khosta77/stm32g0-dev-board/RULES.md

# Правила расстановки и трассировки g0_dev_board

Свод практик, выработанных при трассировке платы и сверенных с документацией производителей.
Ссылаться на пункты как `RULES.md §N.M`. Стек, назначение листов и нумерация обозначений — в `CLAUDE.md`.
Источники — в конце файла, ссылки вида [S1].

## 1. Порядок работы

1.1. Плата разводится вручную, без автотрассировщика. Расстановка и дорожки задаются координатами
     (скрипты pcbnew или MCP KiCad) и проверяются рендером.

1.2. Работа идёт малыми блоками: блок → DRC → рендер → коммит → ревью → следующий блок.
     Порядок блоков: FT232 → ST-Link → Ethernet (W5500) → питание (LDO, +3.3V, JP101) → МК G0B1 →
     флэш/SD → шилд и гребёнки ЛА → шелкография.

1.3. Компоненты блока расставляются от точки входа (разъём, источник сигнала) и поворачиваются так,
     чтобы связи шли без пересечений и лишних переходов.

1.4. Между шагами плату могут править руками в KiCad. Перед любой автоматической правкой — `git diff`.
     Ручные правки не затираются: их переносят в скрипт блока или коммитят отдельно.

1.5. Перед правкой файлов скриптом KiCad закрыт (нет `*.lck`), изменения — на чистом git.

1.6. Требования производителя чипа (layout guide, app note) важнее общих правил этого файла.
     Перед разводкой блока его руководство читается, отступления фиксируются в коммите.

## 2. Геометрия дорожек

2.1. Сегменты только 0°, 90° и 45°. Повороты — фаской 45°, прямых и острых углов нет.
     Исключение: излом внутри площадки (например, связь площадок экрана разъёма через центры).
     Причина — технологичность (острые углы и узкие клинья у площадок дают «кислотные ловушки»
     при травлении) и аккуратность [S9]. На частотах платы прямой угол на сигнал не влияет [S7, S8],
     поэтому правило не повод удлинять критичную линию.

2.1a. Ответвления (Т-отводы) тоже не под 90°: ветвь отходит от линии отрезком 45° (Y-отвод).
     Это касается и отводов, сходящихся в центре площадки.

2.2. Диагонали 45° делаются длинными, где позволяет место: путь короче и ровнее
     (пример — SWDIO от R219 к JP801).

2.3. Сигнал идёт от элемента к элементу кратчайшим путём на одном слое.

2.4. Параллельные диагонали соседних выводов с шагом 0.5–0.65 мм не помещаются (зазор < 0.2 мм).
     Веер от ряда выводов делается «лесенкой»: дорожки выходят горизонтально и поворачивают
     по очереди, крайний вывод уходит дальше всех.

## 3. Ширина дорожек

3.1. Сигнальная дорожка от чипа к чипу — по ширине меньшей из площадок на концах (технологичность:
     дорожка не шире площадки). Для пар с контролем импеданса действует §3.5, для питания — §3.4.

3.2. После последовательного резистора ширина — по площадке чипа-приёмника
     (пример: от FT232 0.4 мм до R304/R305, дальше 0.3 мм к МК).

3.3. Минимальная ширина — 0.3 мм. Если 0.3 не проходит между площадками (ID разъёма USB),
     это фиксируется в сообщении коммита.

3.4. Питание: VBUS и +5V — 0.5 мм (по площадке разъёма USB). Отводы питания к выводам — по площадке
     вывода. Магистрали +3V3_STL на B.Cu — 0.3–0.4 мм. Ширина магистрали проверяется по току
     калькулятором завода (IPC-2152) [S15]; цифры не берутся по памяти.

3.5. Пары с контролем импеданса на стеке JLC 7628 (препрег 0.2104 мм, εr 4.4):
     - USB FS: 0.3 мм при шаге выводов 0.5 мм (~96 Ом); 0.35 мм / зазор 0.29 мм (~95 Ом).
       Цель по TI — 90 Ом ±15 % [S14].
     - Ethernet MDI 100 Ом: 0.3 мм / зазор 0.24 мм (~100 Ом по оценке). Укладывается в WIZnet:
       ширина 6–12 mil (0.15–0.3 мм), зазор в паре ≤ 10 mil (0.254 мм) [S1].
     Окончательные ширины — по калькулятору завода, импеданс зависит от маски и толщины меди [S2].

## 4. Переходные отверстия и слои

4.1. Переходные 0.4/0.3 мм (площадка/сверло). Кольцо 0.05 мм подтвердить у завода.

4.2. Стек: F.Cu сигналы / In1 GND / In2 GND / B.Cu. Оба внутренних слоя — сплошная GND без разрезов;
     аналоговая и цифровая части разносятся расстановкой, а не делением земли [S5, S1].

4.3. B.Cu — под силовые магистрали (+3V3_STL, VBUS, позже +3.3V) и под неизбежные переходы сигналов.
     B.Cu тоже держится планарным: перед магистралью проверить, какие области отрезаны жгутами.

4.4. Переход сигнала на B.Cu допустим только если его нельзя избежать по топологии
     (порядок выводов, захваченный вывод). Каждый такой переход указывается в коммите.
     В линиях MDI (TX±, RX± между W5500 и J401) переходных нет совсем [S1]. В цепях кварца — тоже [S2].

4.5. GND-выводы микросхем — переходными под корпусом (на внутренние GND). Это освобождает
     пространство вдоль ряда выводов для сигналов. Аналогично — выход захваченного сигнала под корпусом.

4.6. Если второй конец сигнала — THT-вывод, второе переходное не нужно: B.Cu садится прямо на вывод.

4.7. Сигнальное переходное F.Cu ↔ B.Cu меняет опорный слой In1 → In2. Рядом с ним, не дальше 1 мм
     от центра, ставится переходное GND — мост для обратного тока [S11, S12]. Для THT-вывода по §4.6
     мостом служит ближайшее GND-переходное или GND-вывод в пределах 1 мм; если его нет — ставится.
     Исключение: в плотных пучках, где в кольце 0.7-1.0 мм нет места без сдвига самих сигнальных
     переходов, мост допускается дальше (у g0_dev_board: 18 переходов, ближайший GND 1.1-5.6 мм —
     шина SPI2 у J806, ряд A0-A4, SWDIO, W_RST, колонка x 130 у W5500). Оценка: In1/In2 обе GND
     и сшиты по плате; лишняя индуктивность петли ~0.5 нГн (~0.5 Ом на 100 МГц) — несущественно.

4.8. Ряды переходных под корпусом и вдоль дорожек вырезают в плоскостях антипады. После заливки
     проверить, что под сигнальными линиями In1 не разорвана в щель.

## 5. Питание и развязка

5.1. Порядок: питание → конденсатор → нагрузка. Питание входит в площадку конденсатора,
     к выводу питания дорожка идёт от этой же площадки. Т-отводов к конденсатору нет [S4].

5.2. Переходное питания у конденсатора ставится со стороны, противоположной выводу нагрузки.

5.3. Несколько конденсаторов на одной шине — последовательно: источник → C1 → C2 → нагрузка
     (пример: D204 → C210 → C212 → +5V).

5.4. GND конденсатора — своё переходное вплотную к площадке, дорожка к нему короткая и не тоньше
     0.4 мм: индуктивность монтажа задают площадки и переходные, а не сам конденсатор [S3, S10].

5.5. Развязка каждого вывода VDD — по нетлисту, не по текстам на схеме (тексты бывают устаревшими).
     Один конденсатор на один вывод; конденсатор — на той же стороне, что и чип [S4, S6].

## 6. Длины и пары

6.1. Равная длина обязательна только для дифпар (USB, MDI): разница ≤ 0.5 мм, предел 1.27 мм [S13].
     Шины SWD, I2C, SPI на скоростях платы выравнивания не требуют: перекос в сантиметры даёт
     десятки пикосекунд при периоде в десятки наносекунд [S16, S17]. Змейки на них не делаются,
     линии ведутся кратчайшим путём.

6.2. Длина пары считается для всей линии от вывода до вывода, включая участки по обе стороны
     последовательных элементов. Отводы (терминаторы, подтяжки) в длину пути не входят.
     KiCad показывает длину каждой цепи отдельно и учитывает отводы — сверять по скрипту.

6.3. Выравнивание пары — змейкой с фасками 45° на одной линии, на участке, где линии пары уже
     разошлись, ближе к месту, где возникла разница.

6.4. Кварц — вплотную к чипу, дорожки OSC короткие [S2]. Корпус симметричен относительно выводов OSC,
     нагрузочные конденсаторы — симметрично, их GND — переходными рядом, на ближайшую к чипу землю.

6.5. Дифпары идут параллельно с постоянным зазором. Если порядок линий у разъёма и у чипа зеркальный
     (это не зависит от поворота чипа), пара один раз перекрещивается:
     - MDI — без переходных: одна линия проходит между площадками последовательного конденсатора
       другой линии (§7.2) или огибает THT-вывод разъёма;
     - USB — так же, если есть последовательный элемент; иначе одна линия уходит на B.Cu
       на минимальной длине с GND-переходным по §4.7.

6.6. Цепи кварца (AN2867 [S2], WIZnet [S1]):
     - под кварцем, между его выводами и нагрузочными конденсаторами чужих дорожек нет;
     - ВЧ-линии (SPI, тактовые, MDI) — в стороне; рядом с OSC они допустимы только на выходе
       из соседних выводов корпуса;
     - один кварц — одному чипу.
     Исключение: дорожки на B.Cu под корпусом THT-кварца (Y401) допускаются, если на In1/In2
     под ним сплошная GND, а до площадок кварца не меньше 0.5 мм. Нужно, когда другого пути
     для линий нет (так у Y401: только там помещаются линии от МК к J803/J804/J805).
     Исключение 2: линии SPI W5500 (выводы 32-36) по B.Cu пересекают отрезки X0/X1 между
     площадками кварца и выводами 30/31 W5500 — перпендикулярно, вне корпуса кварца, при
     сплошной GND на In1/In2. Другого пути от МК к выводам 32-36 нет: они лежат по другую
     сторону выводов 30/31, а под кварцем пять линий не помещаются.

## 7. Расстановка

7.1. ESD-защита — первой у разъёма, перед остальными компонентами линии.

7.2. Резистор или конденсатор 0805 работает как мостик: между его площадками (0.8 мм у R, 0.9 мм у C)
     проходит дорожка 0.3 мм. Так линию пропускают через «петлю» без перехода (SWCLK под R222/R219).

7.3. Курт-ярды не пересекаются. Дорожки внутри чужого курт-ярда допустимы.

7.4. Полоса подписей вдоль гребёнок ЛА J805/J806 — без разъёмов и деталей.

7.5. Перемычки JP801/JP201/JP101 можно ставить под зону шилда: после отладки они снимаются.

7.6. Под шилдом (зона Uno) — только детали высотой ≤ ~8 мм.

7.7. Светодиоды индикации — вне зоны шилда, на видном месте.

7.8. Последовательный (демпфирующий) резистор ставится у передатчика линии: отрезок до него
     работает как индуктивность и ослабляет демпфирование [S18, S19]. Если передатчик на другом
     блоке (SCK/MOSI/CS/RST от МК к W5500) — резистор ставится при разводке того блока.

7.9. Ethernet (WIZnet [S1]):
     - W5500 — как можно ближе к J401, длина MDI ≤ 25 мм (предел 75 мм);
     - зазор между парами TX и RX ≥ 0.5 мм, от остальных цепей ≥ 0.5 мм, по возможности с GND между ними;
     - между W5500 и J401 не проходят цифровые линии; кварц и другие ВЧ-источники — в стороне от MDI;
     - терминаторы RX — у приёмника (W5500).

7.10. Под передней (кабельной) частью J401 во внутренних слоях GND вырез [S1]: от полосы ниже
      ряда выводов 1–8 до края платы. MDI до самых выводов идёт над сплошной GND.
      В HR911105A магнитика встроена, и прямо о таком корпусе WIZnet не говорит — это осторожное
      толкование, его можно пересмотреть.

## 8. Проверка блока перед коммитом

8.1. `kicad-cli pcb drc --schematic-parity`: 0 нарушений внутри блока, 0 расхождений со схемой.
     Неподключёнными допускаются только межблочные цепи; они перечисляются в коммите.

8.2. Скрипт углов: 0 сегментов с наклоном не 0/45/90° (допуск 0.01°), 0 поворотов острее 135°,
     0 Т-отводов под 90° (проверяются и середины сегментов, и центры площадок).

8.3. Длины пар — скриптом по §6.2.

8.4. Скрипт переходных: у каждого сигнального переходного есть GND-переходное в пределах 1 мм (§4.7);
     в цепях MDI и OSC переходных нет (§4.4).

8.5. Рендер блока (F.Cu + B.Cu) и визуальная проверка.

8.6. Изменения схемы — ERC 0, текстовые блоки и поля (Description, LCSC) обновлены вместе с символом.

8.7. Факты о номерах деталей (LCSC и т.п.) не придумываются: если номер неизвестен, поле остаётся
     пустым и это отмечается.

## 9. Коммиты

9.1. Conventional Commits: заголовок на английском, тело на русском.
9.2. В теле: что сделано, какие переходы на B.Cu и почему, отклонения от правил, что осталось неподключённым.

## Источники

- [S1] WIZnet, Hardware Design Guide и Ethernet Design Guide: https://docs.wiznet.io/Design-Guide/hardware_design_guide
- [S2] ST AN2867, Oscillator design guide, раздел 7.1:
  https://www.st.com/resource/en/application_note/an2867-oscillator-design-guide-for-stm32-microcontrollers-stmicroelectronics.pdf
- [S3] TI SPRAC76G, индуктивность монтажа конденсаторов:
  https://www.ti.com/document-viewer/ja-jp/lit/html/SPRAC76G/GUID-A8B7C278-98DB-4D34-A92C-5DA11A9E4475
- [S4] Microchip, Decoupling Capacitors:
  https://onlinedocs.microchip.com/oxy/GUID-D6315DA4-4399-4D39-80F4-F1F66A173640-en-US-3/GUID-ADE90D4D-2E78-42F4-A206-D6E72CECC5CA.html
- [S5] H. Ott, разбиение вместо разреза плоскости (пересказ Autodesk):
  https://www.autodesk.com/products/fusion-360/blog/everyday-app-note-successfully-design-mixed-signal-pcb-partitioning/
- [S6] ST AN5096 (STM32G0 hardware): 100 нФ на каждый VDD, 4.7 мкФ общий — по пересказу, сверить с PDF:
  https://www.eevblog.com/forum/beginners/stm32g0-series-power-supply
- [S7] E. Bogatin, прямые углы: https://www.signalintegrityjournal.com/articles/2104-should-worry-about-90-degree-bends-in-circuit-board-traces
- [S8] Altium, мифы про углы: https://resources.altium.com/p/pcb-routing-angle-myths-45-degree-angle-versus-90-degree-angle
- [S9] NextPCB, acid traps: https://www.nextpcb.com/blog/acid-traps
- [S10] Altium, подключение конденсаторов: https://resources.altium.com/p/decoupling-capacitor-connections-traces-or-vias
- [S11] RF Essentials, переход между слоями:
  https://rfessentials.com/rf-knowledge-base/what-is-the-proper-technique-for-transitioning-a-signal-between-layers-on-a-mult/
- [S12] ICD, No one-way trips: https://www.icd.com.au/articles/No_oneway_trips_PCBD-Apr2014.pdf
- [S13] TI TUSB2036, layout: https://www.ti.com/document-viewer/TUSB2036/datasheet/layout
- [S14] TI SLLA414: https://ti.com/lit/slla414
- [S15] PCBSync, IPC-2152: https://pcbsync.com/?p=32084
- [S16] критическая длина: https://engineering-notes-010.pages.dev/09-Electrical-Foundations/Signal-Integrity
- [S17] выравнивание тактов и данных: https://applied-ee.github.io/ee-notebook/docs/measurement/digital-logic-protocols/clock-data-alignment
- [S18] Sigcon, How Close is Close Enough: https://sigcon.com/Pubs/edn/close.htm
- [S19] Zuken, размещение согласующих резисторов:
  https://www.zuken.com/us/blog/tech-tip-termination-resistor-placement-with-pin-pair-constraints-in-cr-8000/
