khosta77/stm32g0-dev-board/manufacturing/BOM-g0_dev_board.csv

Comment | Designator | Footprint | LCSC Part #
100n | C101,C102,C103,C105,C107,C201,C202,C204,C205,C209,C212,C303,C304,C305,C403,C404,C405,C408,C410,C412,C413,C503,C505,C702 | C_0805_2012Metric | C49678
4.7u | C104,C203,C206,C306,C416 | C_0805_2012Metric | C1779
6.8p C0G | C106,C108 | C_0805_2012Metric | C1832
10u | C207,C210,C409,C414,C502,C504 | C_0805_2012Metric | C15850
22p | C208,C211 | C_0805_2012Metric | C1804
10n | C302,C415,C417 | C_0805_2012Metric | C1710
33p C0G | C401,C402 | C_0805_2012Metric | C157687
6n8 | C406,C407 | C_0805_2012Metric | C1755
22n | C411 | C_0805_2012Metric | C1729
100n X7R | C501,C601,C602 | C_0805_2012Metric | C49678
LED_Red | D201 | LED_0805_2012Metric | C84256
LED_Green | D202 | LED_0805_2012Metric | C2297
LED | D203,D401,D402,D403,D404 | LED_0805_2012Metric | C2297
B120 | D204,D301,D801 | D_SMA | C134421
TX | D302 | LED_0805_2012Metric | C2297
RX | D303 | LED_0805_2012Metric | C2297
BAT54WS | D802 | D_SOD-323_HandSoldering | C124205
MF-MSMF075-2 | F201 | Fuse_1812_4532Metric | C84140
600R@100MHz 0.5A | FB101,FB401 | L_0805_2012Metric | C1017
220R@100MHz 2A | FB301 | L_0805_2012Metric | C85840
USB_B_Mini | J201,J301 | USB_Mini-B_Lumberg_2486_01_Horizontal
F103_SWD | J202 | PinHeader_1x05_P2.54mm_Vertical | C42431835
RJ45_Hanrun_HR911105A_Horizontal | J401 | RJ45_Hanrun_HR911105A_Horizontal | C12074
DM3AT-SF-PEJM5 | J501 | microSD_HC_Hirose_DM3AT-SF-PEJM5 | C114218
Uno_IOH | J801 | PinSocket_1x10_P2.54mm_Vertical | C2905418
Uno_IOL | J802 | PinSocket_1x08_P2.54mm_Vertical | C42431840
Uno_POWER | J803 | PinSocket_1x08_P2.54mm_Vertical | C42431840
Uno_ANALOG | J804 | PinSocket_1x06_P2.54mm_Vertical | C40877
J_LA_L | J805 | PinHeader_1x27_P2.54mm_Vertical
J_LA_R | J806 | PinHeader_1x27_P2.54mm_Vertical
JP_IDD | JP101 | PinHeader_1x02_P2.54mm_Vertical | C42431798
JP_STL_PWR | JP201 | PinHeader_1x02_P2.54mm_Vertical | C42431798
JP_SWD | JP801 | PinHeader_2x03_P2.54mm_Vertical
GREEN | LD701 | LED_0805_2012Metric | C2297
RED | LD702 | LED_0805_2012Metric | C84256
MMBT3904 | Q201 | SOT-23 | C20526
1k | R101,R302,R304,R305 | R_0805_2012Metric | C17513
330 | R201,R202,R203,R306,R307,R424,R425,R426,R427,R429,R430,R701 | R_0805_2012Metric | C17630
4k7 | R204,R210 | R_0805_2012Metric | C17673
100k | R205,R206,R208,R209,R215,R704 | R_0805_2012Metric | C149504
10k | R207,R216,R401,R402,R403,R410,R411,R412,R413,R414,R415,R416,R417,R505,R511,R516,R517 | R_0805_2012Metric | C17414
0 | R211,R213,R214,R223,R301 | R_0805_2012Metric | C17477
1k5 | R212 | R_0805_2012Metric | C4310
36k | R217 | R_0805_2012Metric | C4360
100 | R218,R222 | R_0805_2012Metric | C17408
22 | R219,R220,R221,R404,R405,R406,R407,R408,R409 | R_0805_2012Metric | C17561
2.2k | R303 | R_0805_2012Metric | C17520
1M | R418 | R_0805_2012Metric | C17514
49R9 1% | R419,R420,R422,R423 | R_0805_2012Metric | C17720
10R 1% | R421 | R_0805_2012Metric | C17415
12k4 1% | R428 | R_0805_2012Metric | C30908
10 | R501,R502,R503,R504,R507,R508,R509,R510 | R_0805_2012Metric | C17415
47k | R506,R512,R513,R514,R515 | R_0805_2012Metric | C17713
4.7k | R601,R602 | R_0805_2012Metric | C17673
680 | R702 | R_0805_2012Metric | C17798
10k | RV101 | Potentiometer_Bourns_3314J_Vertical | C36376
RESET | SW701 | SW_SPST_PTS645Sx43SMTR92 | C221880
USER | SW702 | SW_SPST_PTS645Sx43SMTR92 | C221880
STM32G0B1CCT6 | U101 | LQFP-48_7x7mm_P0.5mm | C5270241
USBLC6-2SC6 | U201,U301 | SOT-23-6 | C7519
AP7361C-33E | U202 | SOT-223-3_TabPin2 | C500795
STM32F103CBTx | U203 | LQFP-48_7x7mm_P0.5mm | C8304
FT232RL | U302 | SSOP-28_5.3x10.2mm_P0.65mm | C8690
W5500 | U401 | LQFP-48_7x7mm_P0.5mm | C32843
W25Q32JVSSIQ | U501 | SOIC-8_5.3x5.3mm_P1.27mm | C179173
TMP100 | U601,U602 | SOT-23-6 | C31810
32.768kHz CL7pF | Y101 | Crystal_SMD_G8-2Pin_3.2x1.5mm_HandSoldering | C48615
8MHz | Y201 | Crystal_HC49-4H_Vertical | C21263
25MHz | Y401 | Crystal_HC49-4H_Vertical | C14730
