khosta77/stm32g0-dev-board/g0_dev_board.kicad_pcb

## KiCad design g0_dev_board.kicad_pcb (2026-11-07)

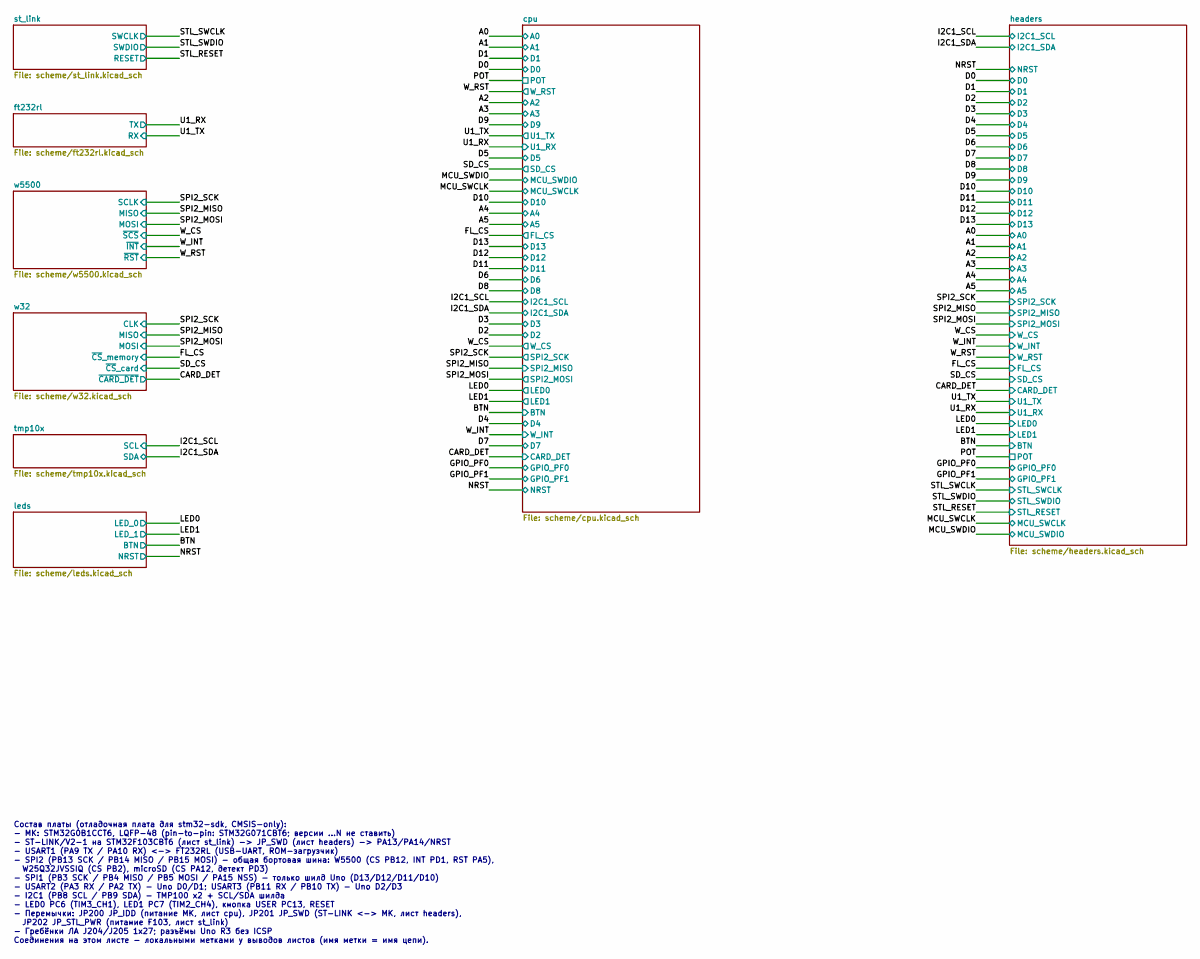
[picture p11: schematic g0_dev_board.kicad_sch, G0 dev board]

Notes on the sheet:
Состав платы (отладочная плата для stm32-sdk, CMSIS-only): - МК: STM32G0B1CCT6, LQFP-48 (pin-to-pin: STM32G071CBT6; версии ...N не ставить) - ST-LINK/V2-1 на STM32F103CBT6 (лист st_link) -> JP_SWD (лист headers) -> PA13/PA14/NRST - USART1 (PA9 TX / PA10 RX) <-> FT232RL (USB-UART, ROM-загрузчик) - S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

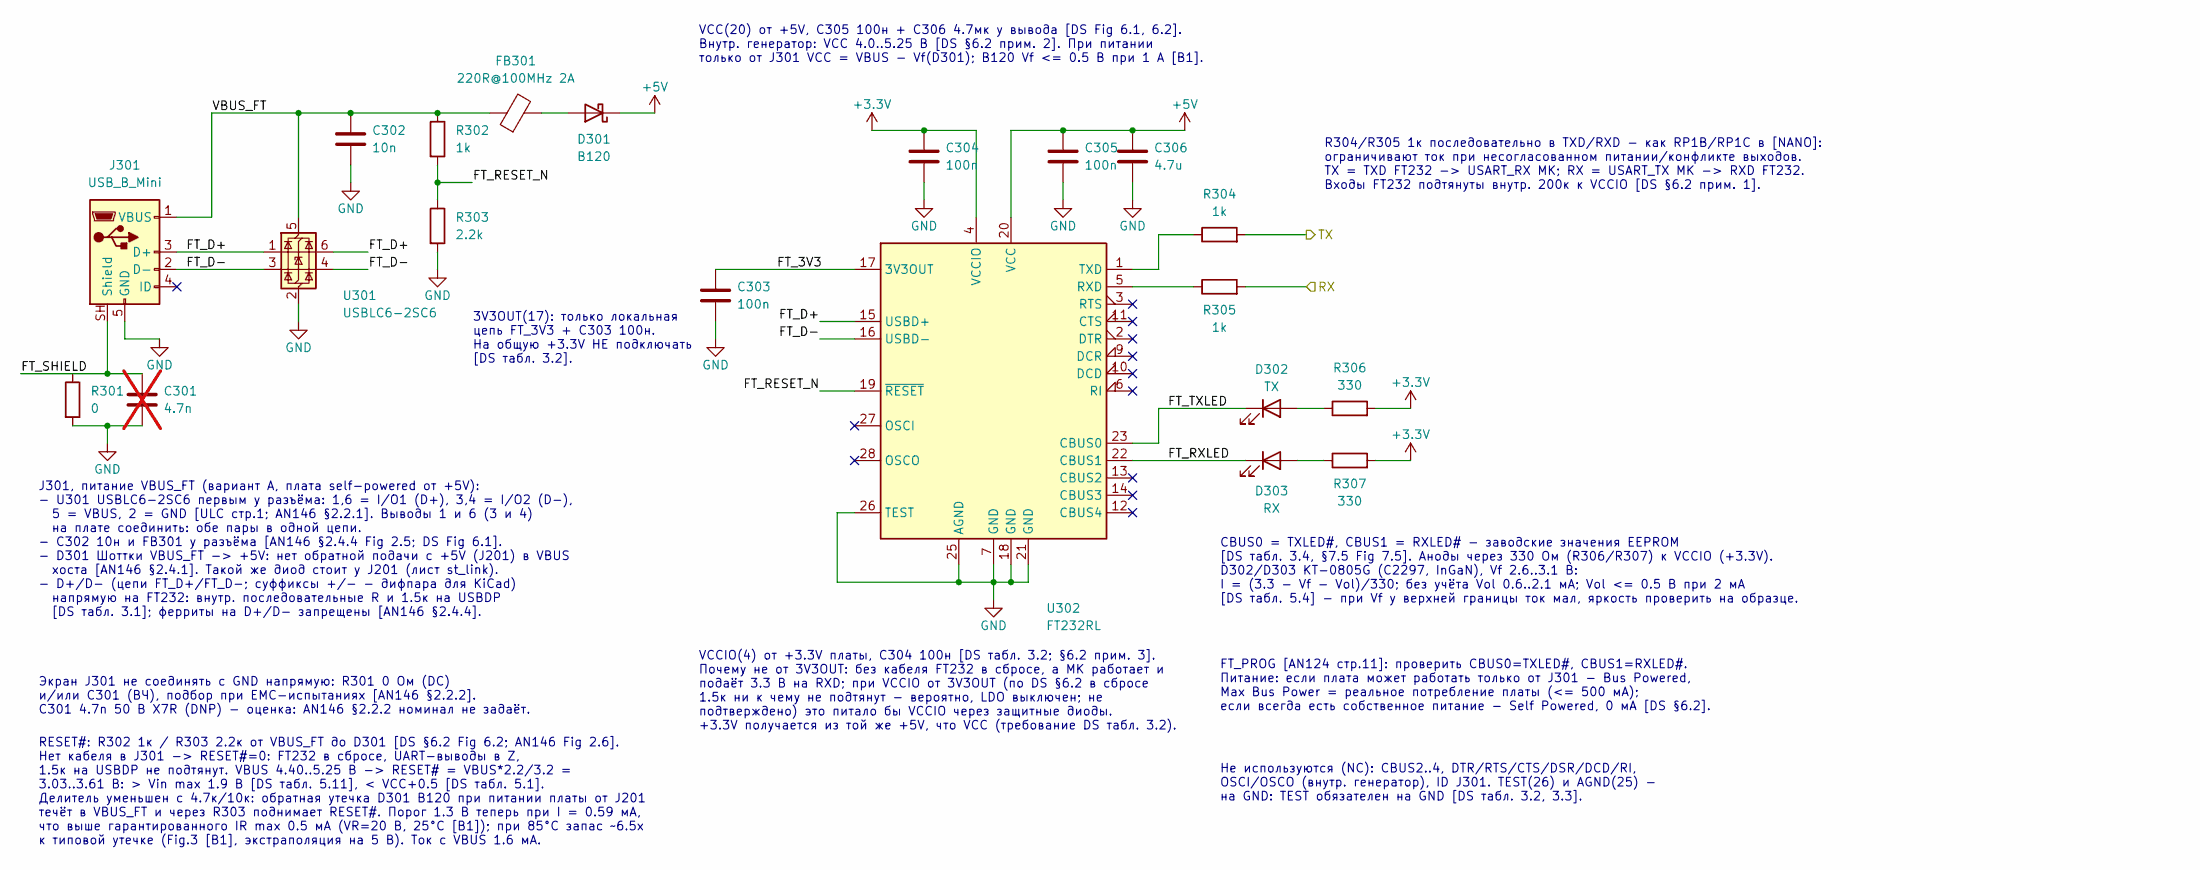
[picture p12: schematic ft232rl.kicad_sch]

Parts:
C301: 4.7n; C_0805_2012Metric; LCSC C1744; not fitted
C302: 10n; C_0805_2012Metric; LCSC C1710
C303, C304, C305: 100n; C_0805_2012Metric; LCSC C49678
C306: 4.7u; C_0805_2012Metric; LCSC C1779
D301: B120; D_SMA; MPN B120-13-F; LCSC C134421
D302: TX; LED_0805_2012Metric; LCSC C2297
D303: RX; LED_0805_2012Metric; LCSC C2297
FB301: 220R@100MHz 2A; L_0805_2012Metric; MPN BLM21PG221SN1D; LCSC C85840
J301: USB_B_Mini; USB_Mini-B_Lumberg_2486_01_Horizontal
R301: 0; R_0805_2012Metric; LCSC C17477
R302, R304, R305: 1k; R_0805_2012Metric; LCSC C17513
R303: 2.2k; R_0805_2012Metric; LCSC C17520
R306, R307: 330; R_0805_2012Metric; LCSC C17630
U301: USBLC6-2SC6; SOT-23-6; MPN USBLC6-2SC6; LCSC C7519
U302: FT232RL; SSOP-28_5.3x10.2mm_P0.65mm; LCSC C8690

Connections:
+3.3V: C304.1, R306.2, R307.2, U302.4 (VCCIO); also elsewhere on the board
+5V: C305.1, C306.1, D301.1 (K), U302.20 (VCC); also elsewhere on the board
/U1_RX: R304.2; also elsewhere on the board
/U1_TX: R305.2; also elsewhere on the board
/ft232rl/FT_3V3: C303.1, U302.17 (3V3OUT)
/ft232rl/FT_D+: J301.3 (D+), U301.1 (I/O1), U301.6 (I/O1), U302.15 (USBD+)
/ft232rl/FT_D-: J301.2 (D-), U301.3 (I/O2), U301.4 (I/O2), U302.16 (USBD-)
/ft232rl/FT_RESET_N: R302.2, R303.1, U302.19 (~RESET)
/ft232rl/FT_RXLED: D303.1 (K), U302.22 (CBUS1)
/ft232rl/FT_SHIELD: C301.1, J301.SH (Shield), R301.1
/ft232rl/FT_TXLED: D302.1 (K), U302.23 (CBUS0)
/ft232rl/VBUS_FT: C302.1, FB301.1, J301.1 (VBUS), R302.1, U301.5 (VBUS)
GND: C301.2, C302.2, C303.2, C304.2, C305.2, C306.2, J301.5 (GND), R301.2, R303.2, U301.2 (GND), U302.7 (GND), U302.18 (GND), U302.21 (GND), U302.25 (AGND), U302.26 (TEST); also elsewhere on the board
unnamed: D301.2 (A), FB301.2
unnamed: D302.2 (A), R306.1
unnamed: D303.2 (A), R307.1
unnamed: R305.1, U302.5 (RXD)
unnamed: R304.1, U302.1 (TXD)

Notes on the sheet:
RESET#: R302 1к / R303 2.2к от VBUS_FT до D301 [DS §6.2 Fig 6.2; AN146 Fig 2.6]. Нет кабеля в J301 -> RESET#=0: FT232 в сбросе, UART-выводы в Z, 1.5к на USBDP не подтянут. VBUS 4.40..5.25 В -> RESET# = VBUS*2.2/3.2 = 3.03..3.61 В: > Vin max 1.9 В [DS табл. 5.11], < VCC+0.5 [DS табл. 5.1]. Делитель 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
R304/R305 1к последовательно в TXD/RXD - как RP1B/RP1C в [NANO]: ограничивают ток при несогласованном питании/конфликте выходов. TX = TXD FT232 -> USART_RX МК; RX = USART_TX МК -> RXD FT232. Входы FT232 подтянуты внутр. 200к к VCCIO [DS §6.2 прим. 1].
3V3OUT(17): только локальная цепь FT_3V3 + C303 100н. На общую +3.3V НЕ подключать [DS табл. 3.2].
VCCIO(4) от +3.3V платы, C304 100н [DS табл. 3.2; §6.2 прим. 3]. Почему не от 3V3OUT: без кабеля FT232 в сбросе, а МК работает и подаёт 3.3 В на RXD; при VCCIO от 3V3OUT (по DS §6.2 в сбросе 1.5к ни к чему не подтянут - вероятно, LDO выключен; не подтверждено) это питало бы VCCIO через защитные дио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
VCC(20) от +5V, C305 100н + C306 4.7мк у вывода [DS Fig 6.1, 6.2]. Внутр. генератор: VCC 4.0..5.25 В [DS §6.2 прим. 2]. При питании только от J301 VCC = VBUS - Vf(D301); B120 Vf <= 0.5 В при 1 А [B1].
FT_PROG [AN124 стр.11]: проверить CBUS0=TXLED#, CBUS1=RXLED#. Питание: если плата может работать только от J301 - Bus Powered, Max Bus Power = реальное потребление платы (<= 500 мА); если всегда есть собственное питание - Self Powered, 0 мА [DS §6.2].
Не используются (NC): CBUS2..4, DTR/RTS/CTS/DSR/DCD/RI, OSCI/OSCO (внутр. генератор), ID J301. TEST(26) и AGND(25) - на GND: TEST обязателен на GND [DS табл. 3.2, 3.3].
J301, питание VBUS_FT (вариант A, плата self-powered от +5V): - U301 USBLC6-2SC6 первым у разъёма: 1,6 = I/O1 (D+), 3,4 = I/O2 (D-), 5 = VBUS, 2 = GND [ULC стр.1; AN146 §2.2.1]. Выводы 1 и 6 (3 и 4) на плате соединить: обе пары в одной цепи. - C302 10н и FB301 у разъёма [AN146 §2.4.4 Fig 2.5; DS Fi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
CBUS0 = TXLED#, CBUS1 = RXLED# - заводские значения EEPROM [DS табл. 3.4, §7.5 Fig 7.5]. Аноды через 330 Ом (R306/R307) к VCCIO (+3.3V). D302/D303 KT-0805G (C2297, InGaN), Vf 2.6..3.1 В: I = (3.3 - Vf - Vol)/330; без учёта Vol 0.6..2.1 мА; Vol <= 0.5 В при 2 мА [DS табл. 5.4] - при Vf у верхней гра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
Экран J301 не соединять с GND напрямую: R301 0 Ом (DC) и/или C301 (ВЧ), подбор при EMC-испытаниях [AN146 §2.2.2]. C301 4.7n 50 В X7R (DNP) - оценка: AN146 §2.2.2 номинал не задаёт.

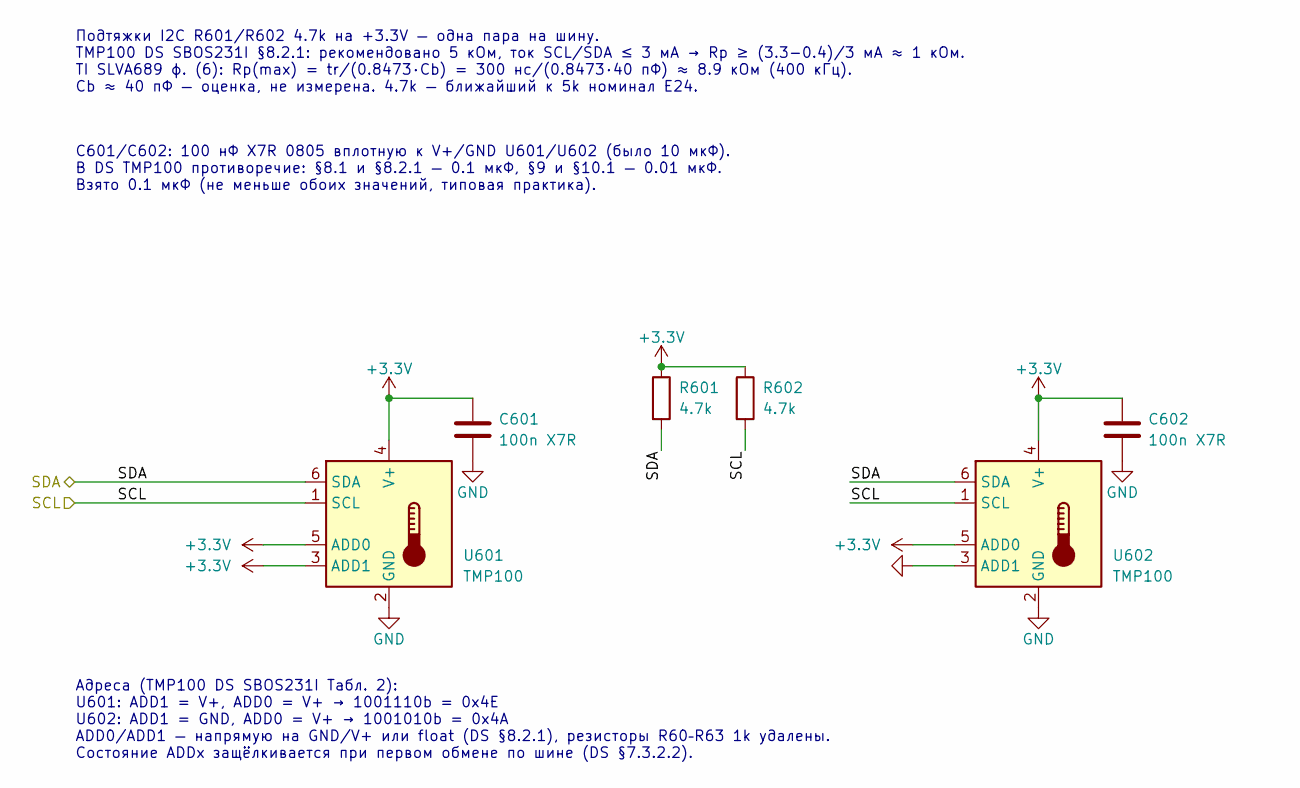
[picture p13: schematic tmp10x.kicad_sch]

Parts:
C601, C602: 100n X7R; C_0805_2012Metric; LCSC C49678
R601, R602: 4.7k; R_0805_2012Metric; LCSC C17673
U601, U602: TMP100; SOT-23-6; LCSC C31810

Connections:
+3.3V: C601.1, C602.1, R601.1, R602.1, U601.3 (ADD1), U601.4 (V+), U601.5 (ADD0), U602.4 (V+), U602.5 (ADD0); also elsewhere on the board
/I2C1_SCL: R602.2, U601.1 (SCL), U602.1 (SCL); also elsewhere on the board
/I2C1_SDA: R601.2, U601.6 (SDA), U602.6 (SDA); also elsewhere on the board
GND: C601.2, C602.2, U601.2 (GND), U602.2 (GND), U602.3 (ADD1); also elsewhere on the board

Notes on the sheet:
Подтяжки I2C R601/R602 4.7k на +3.3V — одна пара на шину. TMP100 DS SBOS231I §8.2.1: рекомендовано 5 кОм, ток SCL/SDA ≤ 3 мА → Rp ≥ (3.3−0.4)/3 мА ≈ 1 кОм. TI SLVA689 ф. (6): Rp(max) = tr/(0.8473·Cb) = 300 нс/(0.8473·40 пФ) ≈ 8.9 кОм (400 кГц). Cb ≈ 40 пФ — оценка, не измерена. 4.7k — ближайший к 5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
Адреса (TMP100 DS SBOS231I Табл. 2): U601: ADD1 = V+, ADD0 = V+ → 1001110b = 0x4E U602: ADD1 = GND, ADD0 = V+ → 1001010b = 0x4A ADD0/ADD1 — напрямую на GND/V+ или float (DS §8.2.1), резисторы R60–R63 1k удалены. Состояние ADDx защёлкивается при первом обмене по шине (DS §7.3.2.2).
C601/C602: 100 нФ X7R 0805 вплотную к V+/GND U601/U602 (было 10 мкФ). В DS TMP100 противоречие: §8.1 и §8.2.1 — 0.1 мкФ, §9 и §10.1 — 0.01 мкФ. Взято 0.1 мкФ (не меньше обоих значений, типовая практика).

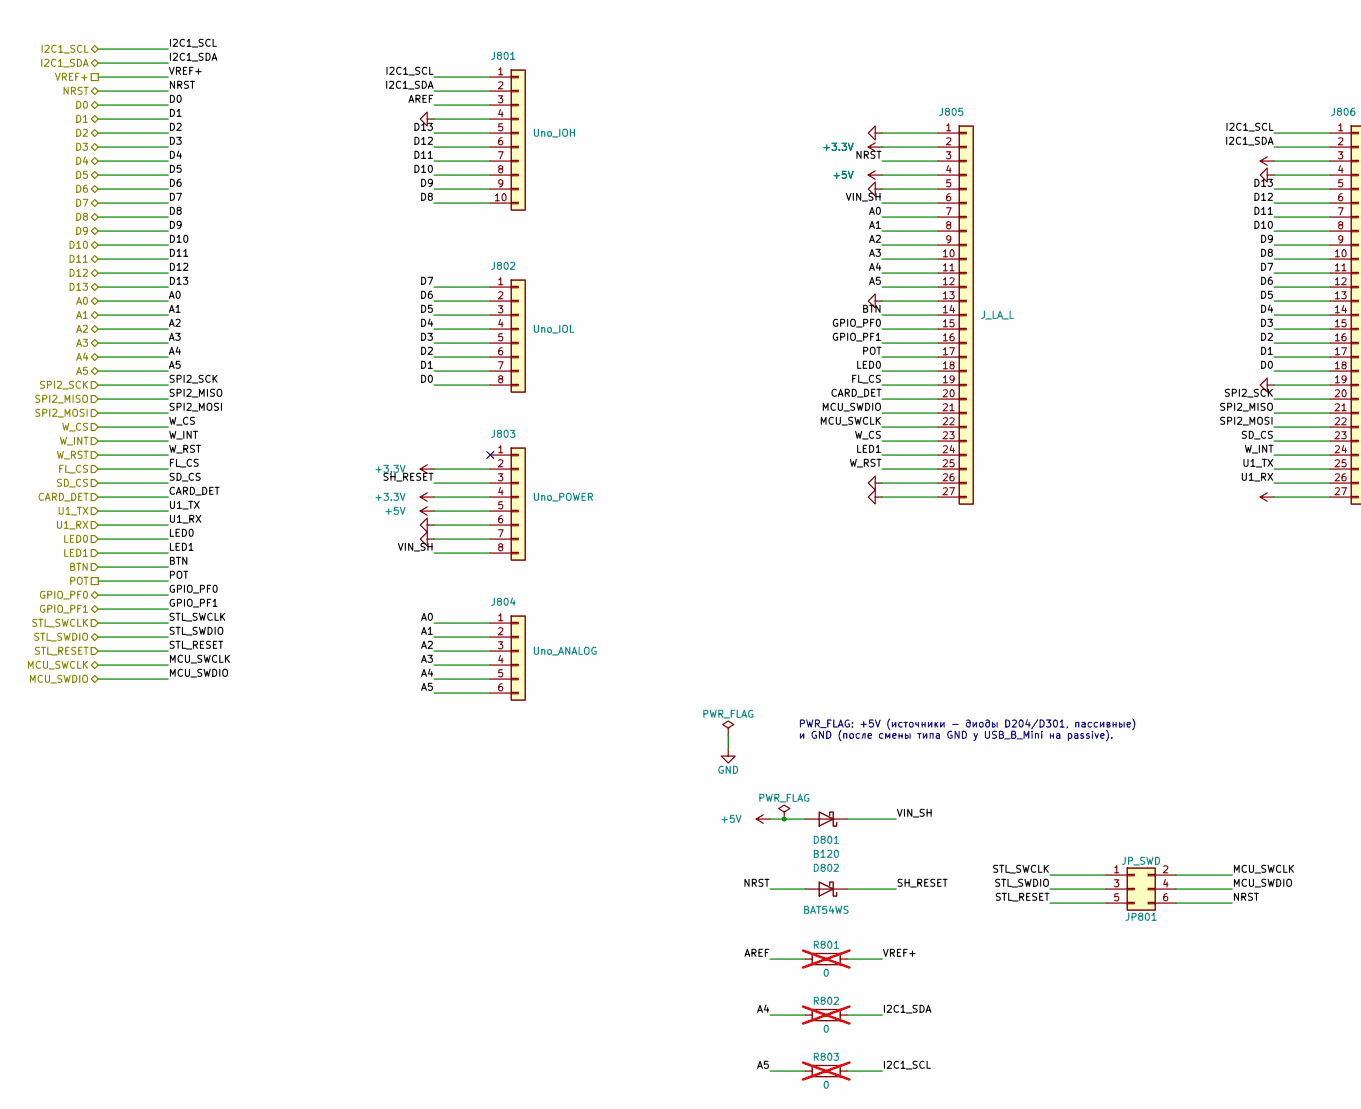
[picture p14: schematic headers.kicad_sch, Uno R3, гребёнки ЛА, JP_SWD, part in row 1, column 1]

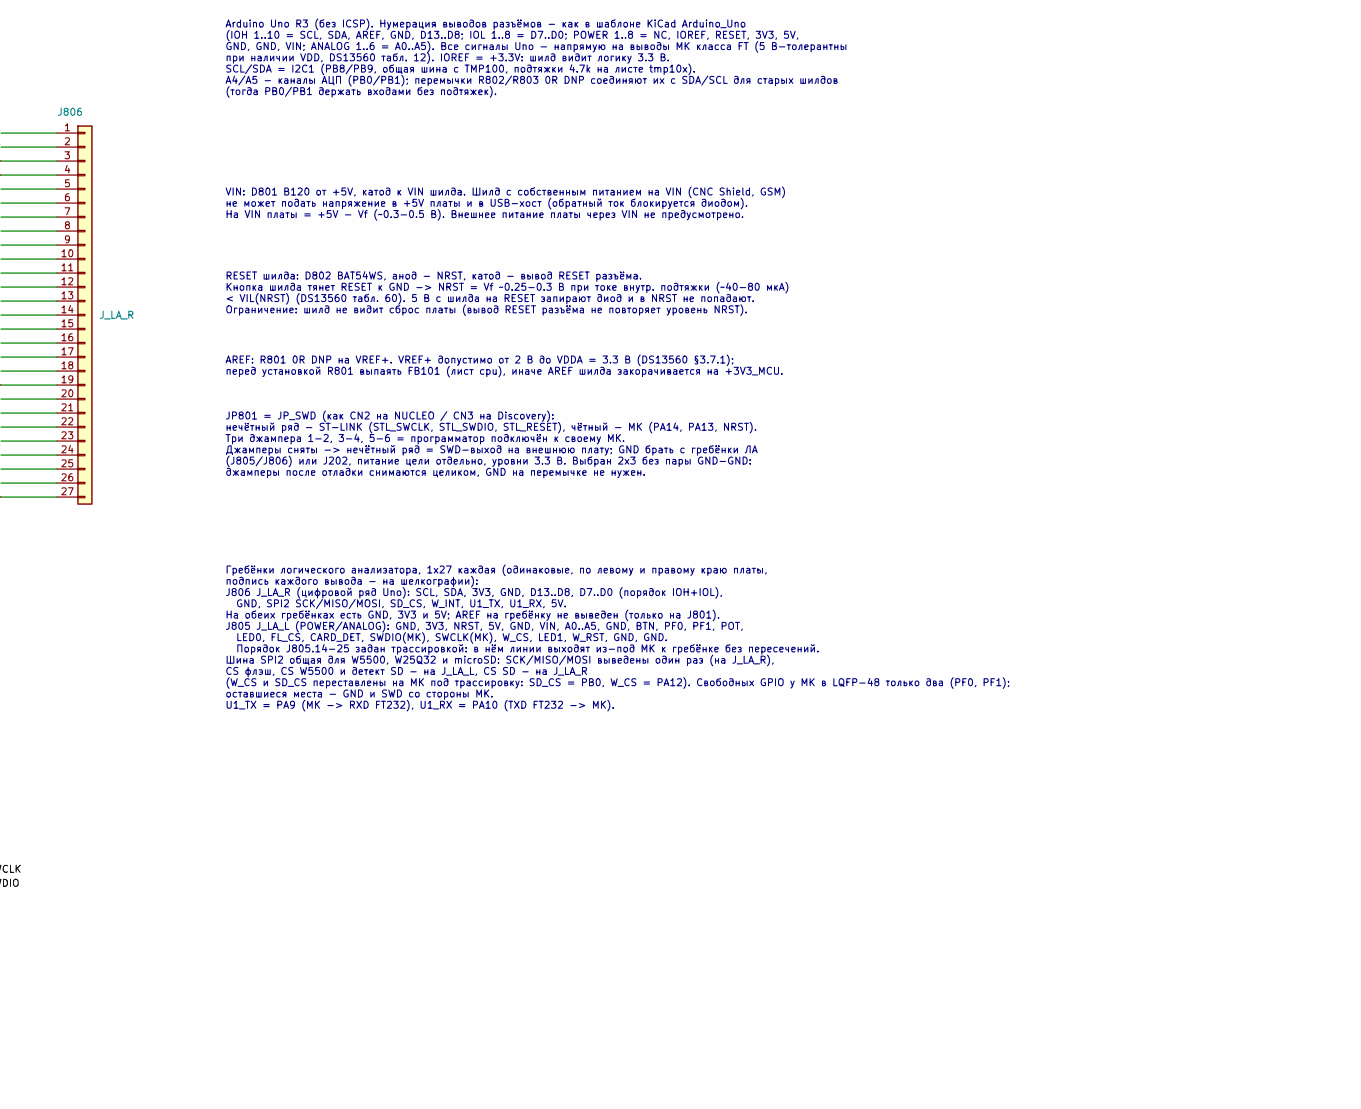
[picture p15: schematic headers.kicad_sch, Uno R3, гребёнки ЛА, JP_SWD, part in row 1, column 2]

Parts:
D801: B120; D_SMA; MPN B120-13-F; LCSC C134421
D802: BAT54WS; D_SOD-323_HandSoldering; MPN BAT54WS; LCSC C124205
J801: Uno_IOH; PinSocket_1x10_P2.54mm_Vertical; LCSC C2905418
J802: Uno_IOL; PinSocket_1x08_P2.54mm_Vertical; LCSC C42431840
J803: Uno_POWER; PinSocket_1x08_P2.54mm_Vertical; LCSC C42431840
J804: Uno_ANALOG; PinSocket_1x06_P2.54mm_Vertical; LCSC C40877
J805: J_LA_L; PinHeader_1x27_P2.54mm_Vertical
J806: J_LA_R; PinHeader_1x27_P2.54mm_Vertical
JP801: JP_SWD; PinHeader_2x03_P2.54mm_Vertical
R801, R802, R803: 0; R_0805_2012Metric; LCSC C17477; not fitted

Connections:
+3.3V: J803.2, J803.4, J805.2, J806.3; also elsewhere on the board
+5V: D801.2 (A), J803.5, J805.4, J806.27; also elsewhere on the board
/A0: J804.1, J805.7; also elsewhere on the board
/A1: J804.2, J805.8; also elsewhere on the board
/A2: J804.3, J805.9; also elsewhere on the board
/A3: J804.4, J805.10; also elsewhere on the board
/A4: J804.5, J805.11, R802.1; also elsewhere on the board
/A5: J804.6, J805.12, R803.1; also elsewhere on the board
/BTN: J805.14; also elsewhere on the board
/CARD_DET: J805.20; also elsewhere on the board
/D0: J802.8, J806.18; also elsewhere on the board
/D1: J802.7, J806.17; also elsewhere on the board
/D2: J802.6, J806.16; also elsewhere on the board
/D3: J802.5, J806.15; also elsewhere on the board
/D4: J802.4, J806.14; also elsewhere on the board
/D5: J802.3, J806.13; also elsewhere on the board
/D6: J802.2, J806.12; also elsewhere on the board
/D7: J802.1, J806.11; also elsewhere on the board
/D8: J801.10, J806.10; also elsewhere on the board
/D9: J801.9, J806.9; also elsewhere on the board
/D10: J801.8, J806.8; also elsewhere on the board
/D11: J801.7, J806.7; also elsewhere on the board
/D12: J801.6, J806.6; also elsewhere on the board
/D13: J801.5, J806.5; also elsewhere on the board
/FL_CS: J805.19; also elsewhere on the board
/GPIO_PF0: J805.15; also elsewhere on the board
/GPIO_PF1: J805.16; also elsewhere on the board
/I2C1_SCL: J801.1, J806.1, R803.2; also elsewhere on the board
/I2C1_SDA: J801.2, J806.2, R802.2; also elsewhere on the board
/LED0: J805.18; also elsewhere on the board
/LED1: J805.24; also elsewhere on the board
/MCU_SWCLK: J805.22, JP801.2; also elsewhere on the board
/MCU_SWDIO: J805.21, JP801.4; also elsewhere on the board
/NRST: D802.2 (A), J805.3, JP801.6; also elsewhere on the board
/POT: J805.17; also elsewhere on the board
/SD_CS: J806.23; also elsewhere on the board
/SPI2_MISO: J806.21; also elsewhere on the board
/SPI2_MOSI: J806.22; also elsewhere on the board
/SPI2_SCK: J806.20; also elsewhere on the board
/STL_RESET: JP801.5; also elsewhere on the board
/STL_SWCLK: JP801.1; also elsewhere on the board
/STL_SWDIO: JP801.3; also elsewhere on the board
/U1_RX: J806.26; also elsewhere on the board
/U1_TX: J806.25; also elsewhere on the board
/W_CS: J805.23; also elsewhere on the board
/W_INT: J806.24; also elsewhere on the board
/W_RST: J805.25; also elsewhere on the board
/headers/SH_RESET: D802.1 (K), J803.3
/headers/VIN_SH: D801.1 (K), J803.8, J805.6
GND: J801.4, J803.6, J803.7, J805.1, J805.5, J805.13, J805.26, J805.27, J806.4, J806.19; also elsewhere on the board
unnamed: J801.3, R801.1

Notes on the sheet:
Гребёнки логического анализатора, 1x27 каждая (одинаковые, по левому и правому краю платы, подпись каждого вывода - на шелкографии): J806 J_LA_R (цифровой ряд Uno): SCL, SDA, 3V3, GND, D13..D8, D7..D0 (порядок IOH+IOL), GND, SPI2 SCK/MISO/MOSI, SD_CS, W_INT, U1_TX, U1_RX, 5V. На обеих гребёнках ест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
Arduino Uno R3 (без ICSP). Нумерация выводов разъёмов - как в шаблоне KiCad Arduino_Uno (IOH 1..10 = SCL, SDA, AREF, GND, D13..D8; IOL 1..8 = D7..D0; POWER 1..8 = NC, IOREF, RESET, 3V3, 5V, GND, GND, VIN; ANALOG 1..6 = A0..A5). Все сигналы Uno - напрямую на выводы МК класса FT (5 В-толерантны при н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
VIN: D801 B120 от +5V, катод к VIN шилда. Шилд с собственным питанием на VIN (CNC Shield, GSM) не может подать напряжение в +5V платы и в USB-хост (обратный ток блокируется диодом). На VIN платы = +5V - Vf (~0.3-0.5 В). Внешнее питание платы через VIN не предусмотрено.
AREF: R801 0R DNP на VREF+. VREF+ допустимо от 2 В до VDDA = 3.3 В (DS13560 §3.7.1); перед установкой R801 выпаять FB101 (лист cpu), иначе AREF шилда закорачивается на +3V3_MCU.
PWR_FLAG: +5V (источники - диоды D204/D301, пассивные) и GND (после смены типа GND у USB_B_Mini на passive).
RESET шилда: D802 BAT54WS, анод - NRST, катод - вывод RESET разъёма. Кнопка шилда тянет RESET к GND -> NRST = Vf ~0.25-0.3 В при токе внутр. подтяжки (~40-80 мкА) < VIL(NRST) (DS13560 табл. 60). 5 В с шилда на RESET запирают диод и в NRST не попадают. Ограничение: шилд не видит сброс платы (вывод R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
JP801 = JP_SWD (как CN2 на NUCLEO / CN3 на Discovery): нечётный ряд - ST-LINK (STL_SWCLK, STL_SWDIO, STL_RESET), чётный - МК (PA14, PA13, NRST). Три джампера 1-2, 3-4, 5-6 = программатор подключён к своему МК. Джамперы сняты -> нечётный ряд = SWD-выход на внешнюю плату; GND брать с гребёнки ЛА (J80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

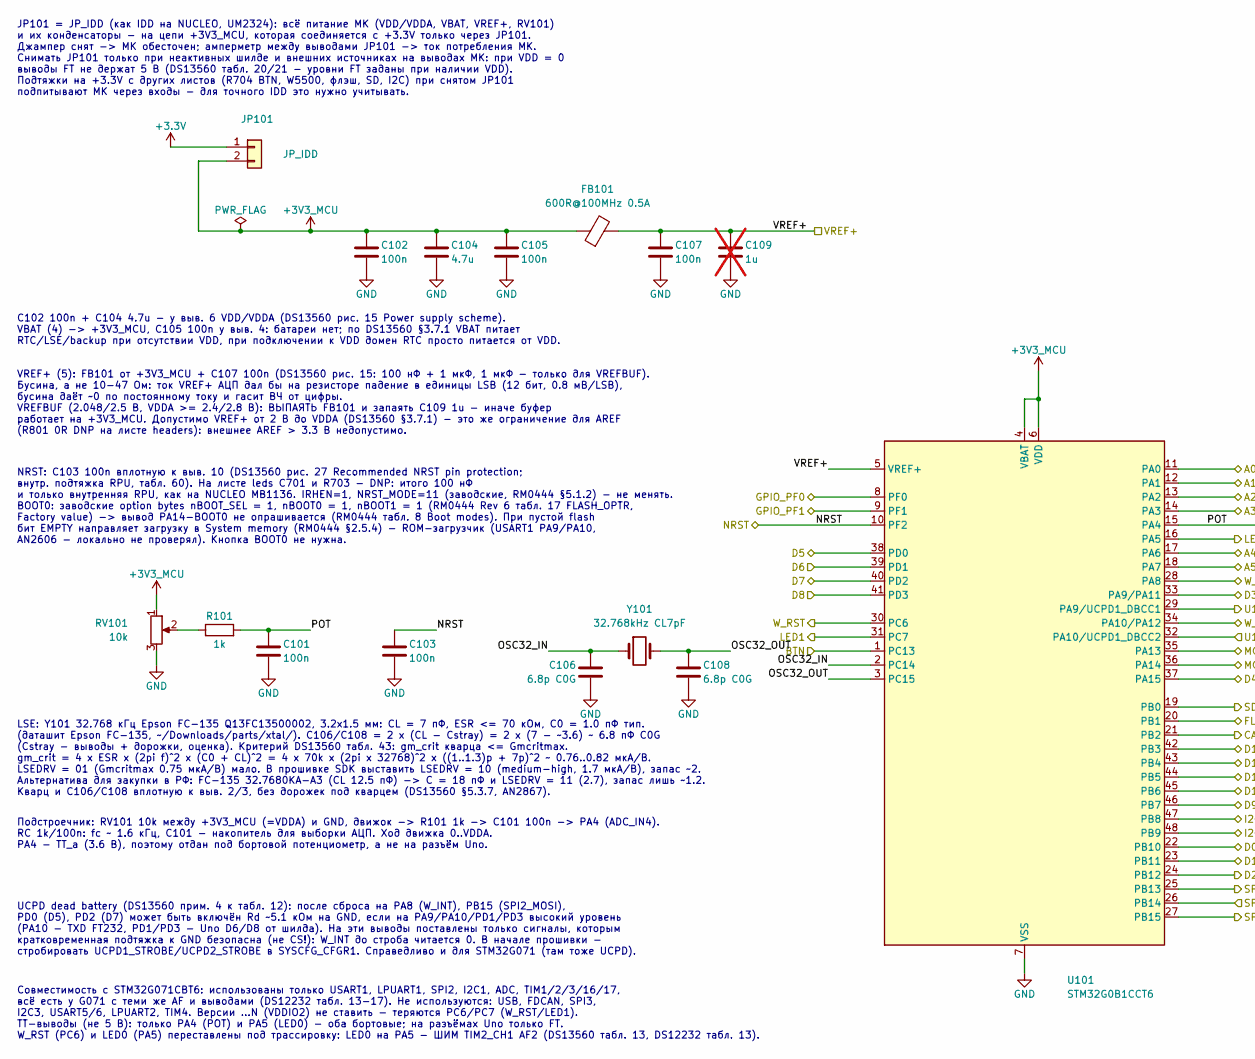
[picture p16: schematic cpu.kicad_sch, MCU STM32G0B1CCT6 (LQFP-48), part in row 1, column 1]

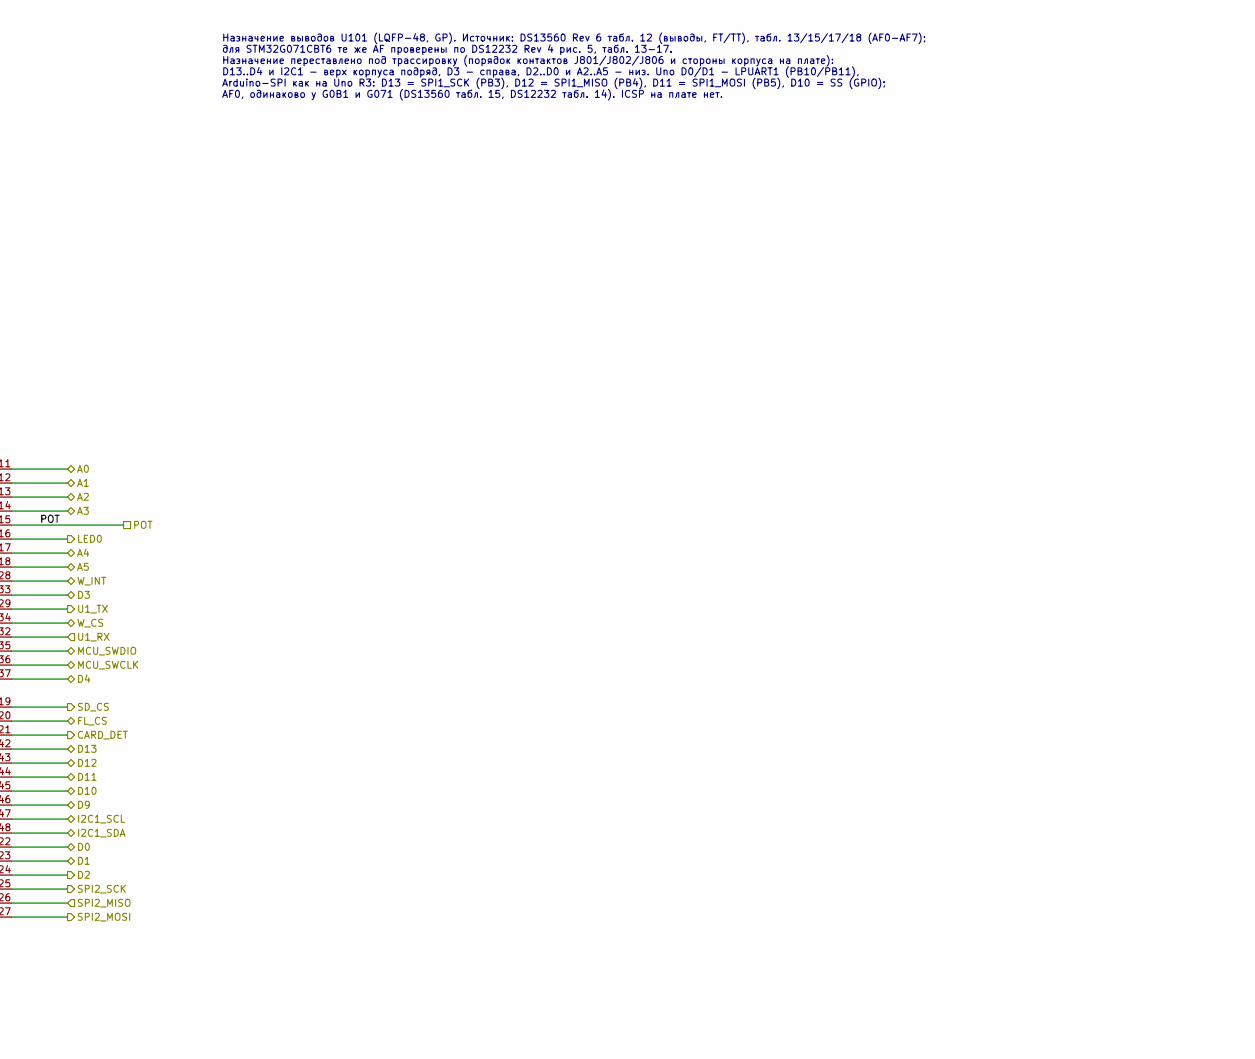
[picture p17: schematic cpu.kicad_sch, MCU STM32G0B1CCT6 (LQFP-48), part in row 1, column 2]

Parts:
C101, C102, C103, C105, C107: 100n; C_0805_2012Metric; LCSC C49678
C104: 4.7u; C_0805_2012Metric; LCSC C1779
C106, C108: 6.8p C0G; C_0805_2012Metric; LCSC C1832
C109: 1u; C_0805_2012Metric; LCSC C28323; not fitted
FB101: 600R@100MHz 0.5A; L_0805_2012Metric; MPN GZ2012D601TF; LCSC C1017
JP101: JP_IDD; PinHeader_1x02_P2.54mm_Vertical; LCSC C42431798
R101: 1k; R_0805_2012Metric; LCSC C17513
RV101: 10k; Potentiometer_Bourns_3314J_Vertical; MPN 3314J-1-103E; LCSC C36376
U101: STM32G0B1CCT6; LQFP-48_7x7mm_P0.5mm; MPN STM32G0B1CCT6; LCSC C5270241
Y101: 32.768kHz CL7pF; Crystal_SMD_G8-2Pin_3.2x1.5mm_HandSoldering; MPN Q13FC13500002; LCSC C48615

Connections:
+3.3V: JP101.1; also elsewhere on the board
+3V3_MCU: C102.1, C104.1, C105.1, FB101.1, JP101.2, RV101.1, U101.4 (VBAT), U101.6 (VDD)
/A0: U101.11 (PA0); also elsewhere on the board
/A1: U101.12 (PA1); also elsewhere on the board
/A2: U101.13 (PA2); also elsewhere on the board
/A3: U101.14 (PA3); also elsewhere on the board
/A4: U101.17 (PA6); also elsewhere on the board
/A5: U101.18 (PA7); also elsewhere on the board
/BTN: U101.1 (PC13); also elsewhere on the board
/CARD_DET: U101.21 (PB2); also elsewhere on the board
/D0: U101.22 (PB10); also elsewhere on the board
/D1: U101.23 (PB11); also elsewhere on the board
/D2: U101.24 (PB12); also elsewhere on the board
/D3: U101.33 (PA9/PA11); also elsewhere on the board
/D4: U101.37 (PA15); also elsewhere on the board
/D5: U101.38 (PD0); also elsewhere on the board
/D6: U101.39 (PD1); also elsewhere on the board
/D7: U101.40 (PD2); also elsewhere on the board
/D8: U101.41 (PD3); also elsewhere on the board
/D9: U101.46 (PB7); also elsewhere on the board
/D10: U101.45 (PB6); also elsewhere on the board
/D11: U101.44 (PB5); also elsewhere on the board
/D12: U101.43 (PB4); also elsewhere on the board
/D13: U101.42 (PB3); also elsewhere on the board
/FL_CS: U101.20 (PB1); also elsewhere on the board
/GPIO_PF0: U101.8 (PF0); also elsewhere on the board
/GPIO_PF1: U101.9 (PF1); also elsewhere on the board
/I2C1_SCL: U101.47 (PB8); also elsewhere on the board
/I2C1_SDA: U101.48 (PB9); also elsewhere on the board
/LED0: U101.16 (PA5); also elsewhere on the board
/LED1: U101.31 (PC7); also elsewhere on the board
/MCU_SWCLK: U101.36 (PA14); also elsewhere on the board
/MCU_SWDIO: U101.35 (PA13); also elsewhere on the board
/NRST: C103.1, U101.10 (PF2); also elsewhere on the board
/POT: C101.1, R101.2, U101.15 (PA4); also elsewhere on the board
/SD_CS: U101.19 (PB0); also elsewhere on the board
/SPI2_MISO: U101.26 (PB14); also elsewhere on the board
/SPI2_MOSI: U101.27 (PB15); also elsewhere on the board
/SPI2_SCK: U101.25 (PB13); also elsewhere on the board
/U1_RX: U101.32 (PA10/UCPD1_DBCC2); also elsewhere on the board
/U1_TX: U101.29 (PA9/UCPD1_DBCC1); also elsewhere on the board
/W_CS: U101.34 (PA10/PA12); also elsewhere on the board
/W_INT: U101.28 (PA8); also elsewhere on the board
/W_RST: U101.30 (PC6); also elsewhere on the board
/cpu/OSC32_IN: C106.1, U101.2 (PC14), Y101.1
/cpu/OSC32_OUT: C108.1, U101.3 (PC15), Y101.2
/cpu/VREF+: C107.1, C109.1, FB101.2, U101.5 (VREF+)
GND: C101.2, C102.2, C103.2, C104.2, C105.2, C106.2, C107.2, C108.2, C109.2, RV101.3, U101.7 (VSS); also elsewhere on the board
unnamed: R101.1, RV101.2

Notes on the sheet:
VREF+ (5): FB101 от +3V3_MCU + C107 100n (DS13560 рис. 15: 100 нФ + 1 мкФ, 1 мкФ - только для VREFBUF). Бусина, а не 10-47 Ом: ток VREF+ АЦП дал бы на резисторе падение в единицы LSB (12 бит, 0.8 мВ/LSB), бусина даёт ~0 по постоянному току и гасит ВЧ от цифры. VREFBUF (2.048/2.5 В, VDDA >= 2.4/2.8 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
Назначение выводов U101 (LQFP-48, GP). Источник: DS13560 Rev 6 табл. 12 (выводы, FT/TT), табл. 13/15/17/18 (AF0-AF7); для STM32G071CBT6 те же AF проверены по DS12232 Rev 4 рис. 5, табл. 13-17. Назначение переставлено под трассировку (порядок контактов J801/J802/J806 и стороны корпуса на плате): D13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
Совместимость с STM32G071CBT6: использованы только USART1, LPUART1, SPI2, I2C1, ADC, TIM1/2/3/16/17, всё есть у G071 с теми же AF и выводами (DS12232 табл. 13-17). Не используются: USB, FDCAN, SPI3, I2C3, USART5/6, LPUART2, TIM4. Версии ...N (VDDIO2) не ставить - теряются PC6/PC7 (W_RST/LED1). TT-в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
Подстроечник: RV101 10k между +3V3_MCU (=VDDA) и GND, движок -> R101 1k -> C101 100n -> PA4 (ADC_IN4). RC 1k/100n: fc ~ 1.6 кГц, C101 - накопитель для выборки АЦП. Ход движка 0..VDDA. PA4 - TT_a (3.6 В), поэтому отдан под бортовой потенциометр, а не на разъём Uno.
C102 100n + C104 4.7u - у выв. 6 VDD/VDDA (DS13560 рис. 15 Power supply scheme). VBAT (4) -> +3V3_MCU, C105 100n у выв. 4: батареи нет; по DS13560 §3.7.1 VBAT питает RTC/LSE/backup при отсутствии VDD, при подключении к VDD домен RTC просто питается от VDD.
NRST: C103 100n вплотную к выв. 10 (DS13560 рис. 27 Recommended NRST pin protection; внутр. подтяжка RPU, табл. 60). На листе leds C701 и R703 - DNP: итого 100 нФ и только внутренняя RPU, как на NUCLEO MB1136. IRHEN=1, NRST_MODE=11 (заводские, RM0444 §5.1.2) - не менять. BOOT0: заводские option byt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
JP101 = JP_IDD (как IDD на NUCLEO, UM2324): всё питание МК (VDD/VDDA, VBAT, VREF+, RV101) и их конденсаторы - на цепи +3V3_MCU, которая соединяется с +3.3V только через JP101. Джампер снят -> МК обесточен; амперметр между выводами JP101 -> ток потребления МК. Снимать JP101 только при неактивных шил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
LSE: Y101 32.768 кГц Epson FC-135 Q13FC13500002, 3.2x1.5 мм: CL = 7 пФ, ESR <= 70 кОм, C0 = 1.0 пФ тип. (даташит Epson FC-135, ~/Downloads/parts/xtal/). C106/C108 = 2 x (CL - Cstray) = 2 x (7 - ~3.6) ~ 6.8 пФ C0G (Cstray - выводы + дорожки, оценка). Критерий DS13560 табл. 43: gm_crit кварца <= Gmcr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
UCPD dead battery (DS13560 прим. 4 к табл. 12): после сброса на PA8 (W_INT), PB15 (SPI2_MOSI), PD0 (D5), PD2 (D7) может быть включён Rd ~5.1 кОм на GND, если на PA9/PA10/PD1/PD3 высокий уровень (PA10 - TXD FT232, PD1/PD3 - Uno D6/D8 от шилда). На эти выводы поставлены только сигналы, которым кратко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
