khosta77/stm32g0-dev-board/g0_dev_board.kicad_pcb

## KiCad design g0_dev_board.kicad_pcb (continued)

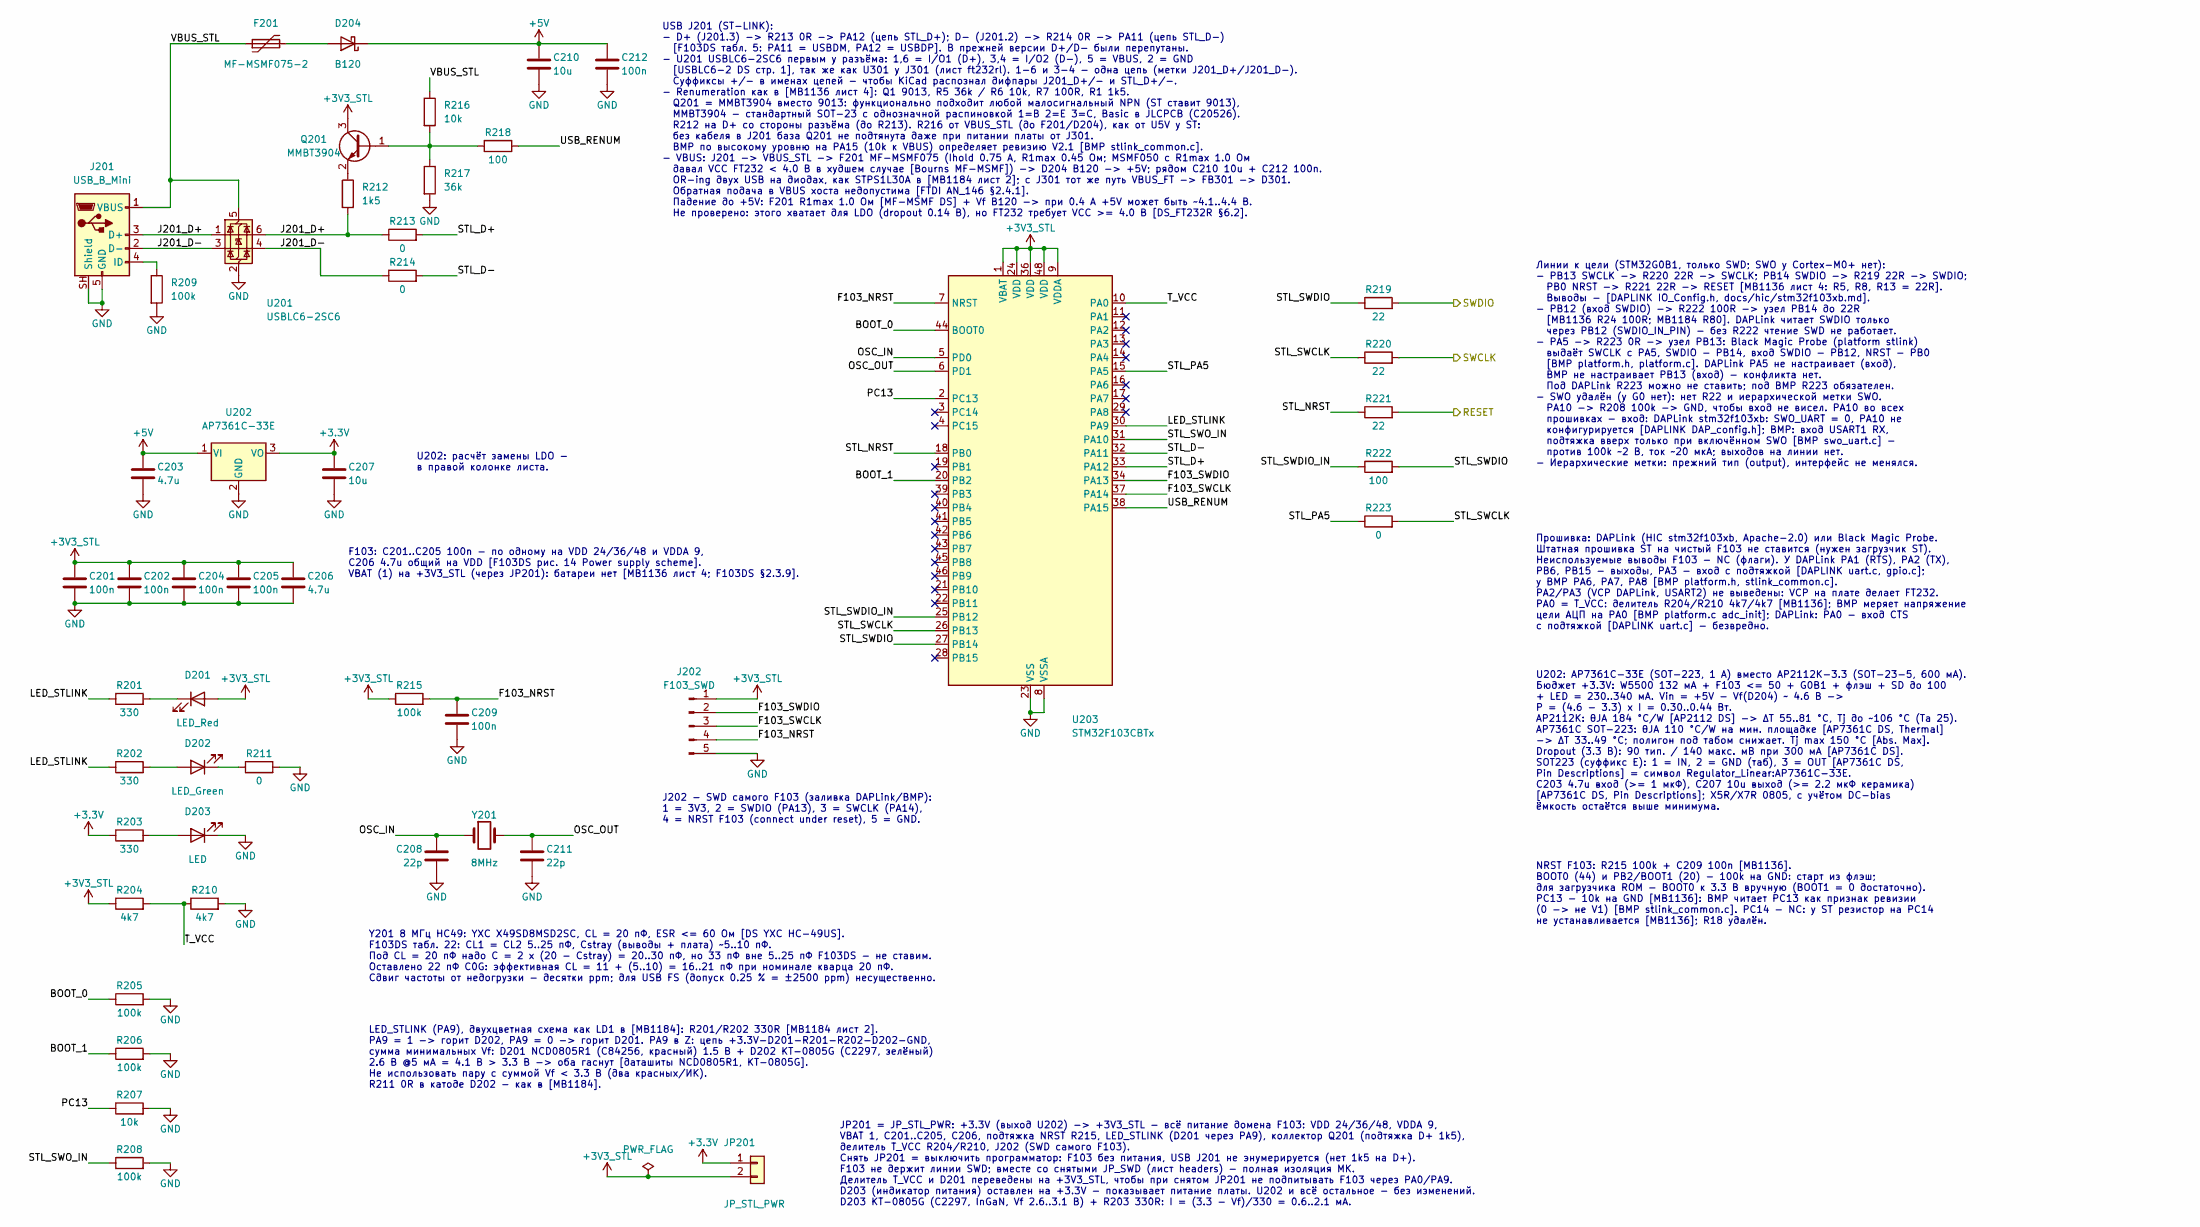
[picture p18: schematic st_link.kicad_sch, STLINK/V2-1]

Parts:
C201, C202, C204, C205, C209, C212: 100n; C_0805_2012Metric; LCSC C49678
C203, C206: 4.7u; C_0805_2012Metric; LCSC C1779
C207, C210: 10u; C_0805_2012Metric; LCSC C15850
C208, C211: 22p; C_0805_2012Metric; LCSC C1804
D201: LED_Red; LED_0805_2012Metric; LCSC C84256
D202: LED_Green; LED_0805_2012Metric; LCSC C2297
D203: LED; LED_0805_2012Metric; LCSC C2297
D204: B120; D_SMA; MPN B120-13-F; LCSC C134421
F201: MF-MSMF075-2; Fuse_1812_4532Metric; MPN MF-MSMF075-2; LCSC C84140
J201: USB_B_Mini; USB_Mini-B_Lumberg_2486_01_Horizontal
J202: F103_SWD; PinHeader_1x05_P2.54mm_Vertical; LCSC C42431835
JP201: JP_STL_PWR; PinHeader_1x02_P2.54mm_Vertical; LCSC C42431798
Q201: MMBT3904; SOT-23; LCSC C20526
R201, R202, R203: 330; R_0805_2012Metric; LCSC C17630
R204, R210: 4k7; R_0805_2012Metric; LCSC C17673
R205, R206, R208, R209, R215: 100k; R_0805_2012Metric; LCSC C149504
R207, R216: 10k; R_0805_2012Metric; LCSC C17414
R211, R213, R214, R223: 0; R_0805_2012Metric; LCSC C17477
R212: 1k5; R_0805_2012Metric; LCSC C4310
R217: 36k; R_0805_2012Metric; LCSC C4360
R218, R222: 100; R_0805_2012Metric; LCSC C17408
R219, R220, R221: 22; R_0805_2012Metric; LCSC C17561
U201: USBLC6-2SC6; SOT-23-6; MPN USBLC6-2SC6; LCSC C7519
U202: AP7361C-33E; SOT-223-3_TabPin2; MPN AP7361C-33E-13; LCSC C500795
U203: STM32F103CBTx; LQFP-48_7x7mm_P0.5mm; MPN STM32F103CBT6; LCSC C8304
Y201: 8MHz; Crystal_HC49-4H_Vertical; MPN X49SD8MSD2SC; LCSC C21263

Connections:
+3.3V: C207.1, JP201.1, R203.1, U202.3 (VO); also elsewhere on the board
+3V3_STL: C201.1, C202.1, C204.1, C205.1, C206.1, D201.2 (A), J202.1, JP201.2, Q201.3 (C), R204.1, R215.1, U203.1 (VBAT), U203.9 (VDDA), U203.24 (VDD), U203.36 (VDD), U203.48 (VDD)
+5V: C203.1, C210.1, C212.1, D204.1 (K), U202.1 (VI); also elsewhere on the board
/STL_RESET: R221.2; also elsewhere on the board
/STL_SWCLK: R220.2; also elsewhere on the board
/STL_SWDIO: R219.2; also elsewhere on the board
/st_link/BOOT_0: R205.1, U203.44 (BOOT0)
/st_link/BOOT_1: R206.1, U203.20 (PB2)
/st_link/F103_NRST: C209.1, J202.4, R215.2, U203.7 (NRST)
/st_link/F103_SWCLK: J202.3, U203.37 (PA14)
/st_link/F103_SWDIO: J202.2, U203.34 (PA13)
/st_link/J201_D+: J201.3 (D+), R212.2, R213.1, U201.1 (I/O1), U201.6 (I/O1)
/st_link/J201_D-: J201.2 (D-), R214.1, U201.3 (I/O2), U201.4 (I/O2)
/st_link/LED_STLINK: R201.1, R202.1, U203.30 (PA9)
/st_link/OSC_IN: C208.1, U203.5 (PD0), Y201.1
/st_link/OSC_OUT: C211.1, U203.6 (PD1), Y201.2
/st_link/PC13: R207.1, U203.2 (PC13)
/st_link/STL_D+: R213.2, U203.33 (PA12)
/st_link/STL_D-: R214.2, U203.32 (PA11)
/st_link/STL_NRST: R221.1, U203.18 (PB0)
/st_link/STL_PA5: R223.1, U203.15 (PA5)
/st_link/STL_SWCLK: R220.1, R223.2, U203.26 (PB13)
/st_link/STL_SWDIO: R219.1, R222.2, U203.27 (PB14)
/st_link/STL_SWDIO_IN: R222.1, U203.25 (PB12)
/st_link/STL_SWO_IN: R208.1, U203.31 (PA10)
/st_link/T_VCC: R204.2, R210.1, U203.10 (PA0)
/st_link/USB_RENUM: R218.2, U203.38 (PA15)
/st_link/VBUS_STL: F201.1, J201.1 (VBUS), R216.1, U201.5 (VBUS)
GND: C201.2, C202.2, C203.2, C204.2, C205.2, C206.2, C207.2, C208.2, C209.2, C210.2, C211.2, C212.2, D203.1 (K), J201.5 (GND), J201.SH (Shield), J202.5, R205.2, R206.2, R207.2, R208.2, R209.2, R210.2, R211.2, R217.2, U201.2 (GND), U202.2 (GND), U203.8 (VSSA), U203.23 (VSS), U203.35 (VSS), U203.47 (VSS); also elsewhere on the board
unnamed: D201.1 (K), R201.2
unnamed: D202.2 (A), R202.2
unnamed: D202.1 (K), R211.1
unnamed: D203.2 (A), R203.2
unnamed: D204.2 (A), F201.2
unnamed: J201.4 (ID), R209.1
unnamed: Q201.1 (B), R216.2, R217.1, R218.1
unnamed: Q201.2 (E), R212.1

Notes on the sheet:
F103: C201..C205 100n - по одному на VDD 24/36/48 и VDDA 9, C206 4.7u общий на VDD [F103DS рис. 14 Power supply scheme]. VBAT (1) на +3V3_STL (через JP201): батареи нет [MB1136 лист 4; F103DS §2.3.9].
Линии к цели (STM32G0B1, только SWD; SWO у Cortex-M0+ нет): - PB13 SWCLK -> R220 22R -> SWCLK; PB14 SWDIO -> R219 22R -> SWDIO; PB0 NRST -> R221 22R -> RESET [MB1136 лист 4: R5, R8, R13 = 22R]. Выводы - [DAPLINK IO_Config.h, docs/hic/stm32f103xb.md]. - PB12 (вход SWDIO) -> R222 100R -> узел PB14 до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
Y201 8 МГц HC49: YXC X49SD8MSD2SC, CL = 20 пФ, ESR <= 60 Ом [DS YXC HC-49US]. F103DS табл. 22: CL1 = CL2 5..25 пФ, Cstray (выводы + плата) ~5..10 пФ. Под CL = 20 пФ надо C = 2 x (20 - Cstray) = 20..30 пФ, но 33 пФ вне 5..25 пФ F103DS - не ставим. Оставлено 22 пФ C0G: эффективная CL = 11 + (5..10) =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
U202: расчёт замены LDO - в правой колонке листа.
JP201 = JP_STL_PWR: +3.3V (выход U202) -> +3V3_STL - всё питание домена F103: VDD 24/36/48, VDDA 9, VBAT 1, C201..C205, C206, подтяжка NRST R215, LED_STLINK (D201 через PA9), коллектор Q201 (подтяжка D+ 1k5), делитель T_VCC R204/R210, J202 (SWD самого F103). Снять JP201 = выключить программатор: F1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
U202: AP7361C-33E (SOT-223, 1 А) вместо AP2112K-3.3 (SOT-23-5, 600 мА). Бюджет +3.3V: W5500 132 мА + F103 <= 50 + G0B1 + флэш + SD до 100 + LED = 230..340 мА. Vin = +5V - Vf(D204) ~ 4.6 В -> P = (4.6 - 3.3) x I = 0.30..0.44 Вт. AP2112K: θJA 184 °C/W [AP2112 DS] -> ΔT 55..81 °C, Tj до ~106 °C (Ta 25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
NRST F103: R215 100k + C209 100n [MB1136]. BOOT0 (44) и PB2/BOOT1 (20) - 100k на GND: старт из флэш; для загрузчика ROM - BOOT0 к 3.3 В вручную (BOOT1 = 0 достаточно). PC13 - 10k на GND [MB1136]: BMP читает PC13 как признак ревизии (0 -> не V1) [BMP stlink_common.c]. PC14 - NC: у ST резистор на PC1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
Прошивка: DAPLink (HIC stm32f103xb, Apache-2.0) или Black Magic Probe. Штатная прошивка ST на чистый F103 не ставится (нужен загрузчик ST). Неиспользуемые выводы F103 - NC (флаги). У DAPLink PA1 (RTS), PA2 (TX), PB6, PB15 - выходы, PA3 - вход с подтяжкой [DAPLINK uart.c, gpio.c]; у BMP PA6, PA7, PA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
J202 - SWD самого F103 (заливка DAPLink/BMP): 1 = 3V3, 2 = SWDIO (PA13), 3 = SWCLK (PA14), 4 = NRST F103 (connect under reset), 5 = GND.
USB J201 (ST-LINK): - D+ (J201.3) -> R213 0R -> PA12 (цепь STL_D+); D- (J201.2) -> R214 0R -> PA11 (цепь STL_D-) [F103DS табл. 5: PA11 = USBDM, PA12 = USBDP]. В прежней версии D+/D- были перепутаны. - U201 USBLC6-2SC6 первым у разъёма: 1,6 = I/O1 (D+), 3,4 = I/O2 (D-), 5 = VBUS, 2 = GND [USBLC6-2 D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
LED_STLINK (PA9), двухцветная схема как LD1 в [MB1184]: R201/R202 330R [MB1184 лист 2]. PA9 = 1 -> горит D202, PA9 = 0 -> горит D201. PA9 в Z: цепь +3.3V-D201-R201-R202-D202-GND, сумма минимальных Vf: D201 NCD0805R1 (C84256, красный) 1.5 В + D202 KT-0805G (C2297, зелёный) 2.6 В @5 мА = 4.1 В > 3.3 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

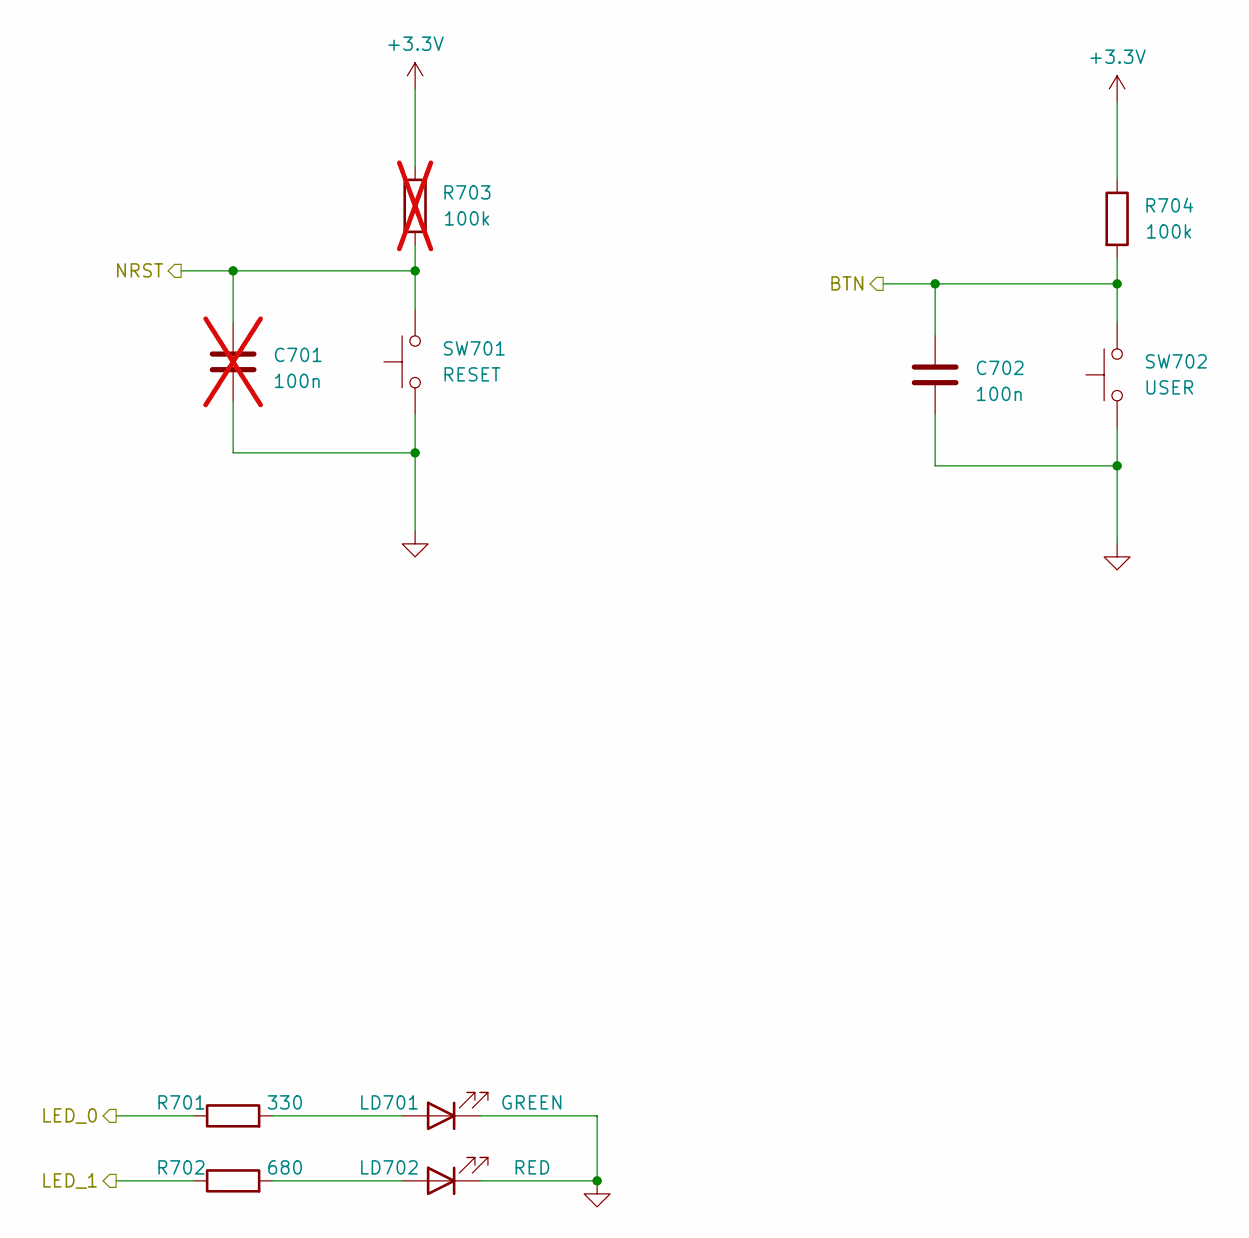
[picture p19: schematic leds.kicad_sch]

Parts:
C701: 100n; C_0805_2012Metric; LCSC C49678; not fitted
C702: 100n; C_0805_2012Metric; LCSC C49678
LD701: GREEN; LED_0805_2012Metric; LCSC C2297
LD702: RED; LED_0805_2012Metric; LCSC C84256
R701: 330; R_0805_2012Metric; LCSC C17630
R702: 680; R_0805_2012Metric; LCSC C17798
R703: 100k; R_0805_2012Metric; LCSC C149504; not fitted
R704: 100k; R_0805_2012Metric; LCSC C149504
SW701: RESET; SW_SPST_PTS645Sx43SMTR92; LCSC C221880
SW702: USER; SW_SPST_PTS645Sx43SMTR92; LCSC C221880

Connections:
+3.3V: R703.1, R704.1; also elsewhere on the board
/BTN: C702.2, R704.2, SW702.2; also elsewhere on the board
/LED0: R701.1; also elsewhere on the board
/LED1: R702.1; also elsewhere on the board
/NRST: C701.2, R703.2, SW701.2; also elsewhere on the board
GND: C701.1, C702.1, LD701.1 (K), LD702.1 (K), SW701.1, SW702.1; also elsewhere on the board
unnamed: LD701.2 (A), R701.2
unnamed: LD702.2 (A), R702.2

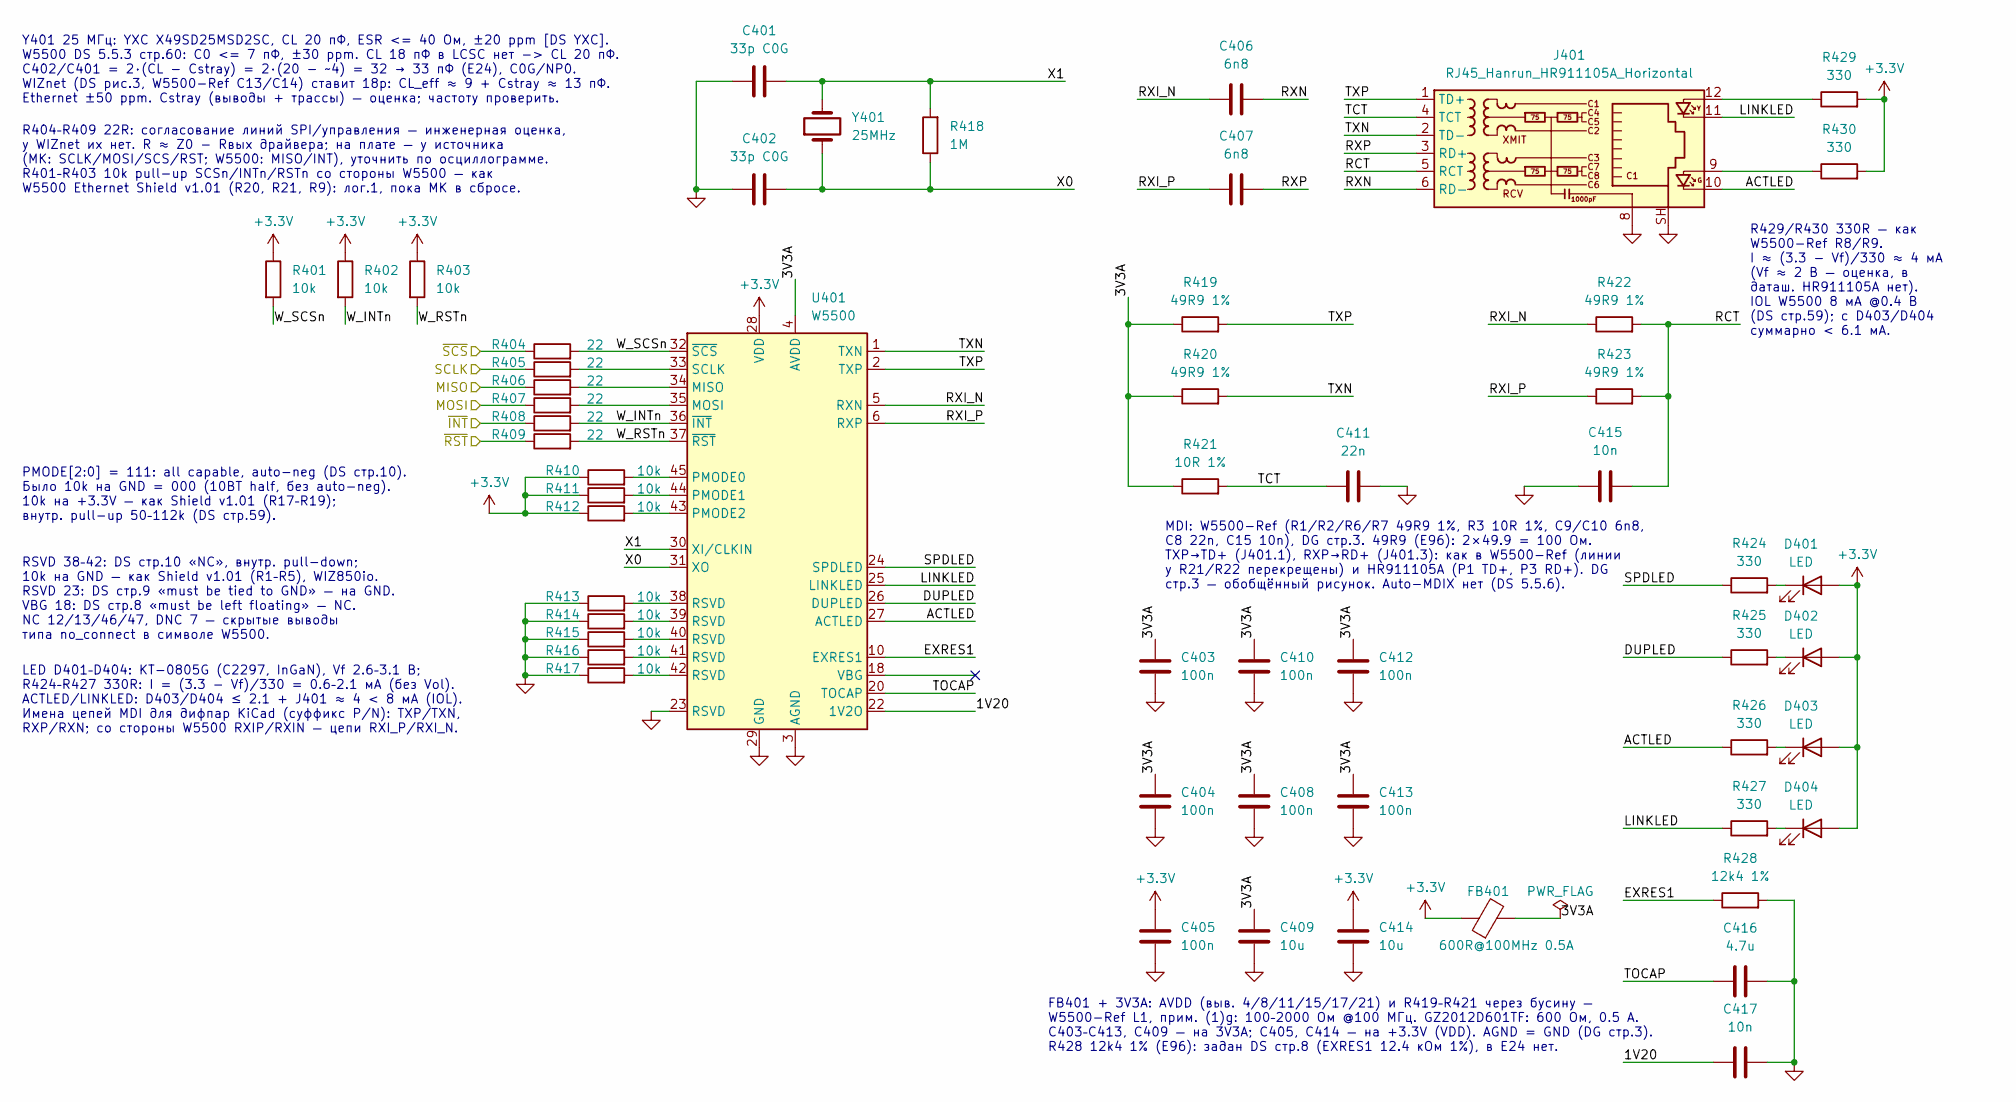
[picture p20: schematic w5500.kicad_sch]

Parts:
C401, C402: 33p C0G; C_0805_2012Metric; LCSC C157687
C403, C404, C405, C408, C410, C412, C413: 100n; C_0805_2012Metric; LCSC C49678
C406, C407: 6n8; C_0805_2012Metric; LCSC C1755
C409, C414: 10u; C_0805_2012Metric; LCSC C15850
C411: 22n; C_0805_2012Metric; LCSC C1729
C415, C417: 10n; C_0805_2012Metric; LCSC C1710
C416: 4.7u; C_0805_2012Metric; LCSC C1779
D401, D402, D403, D404: LED; LED_0805_2012Metric; LCSC C2297
FB401: 600R@100MHz 0.5A; L_0805_2012Metric; MPN GZ2012D601TF; LCSC C1017
J401: RJ45_Hanrun_HR911105A_Horizontal; LCSC C12074
R401, R402, R403, R410, R411, R412, R413, R414, R415, R416, R417: 10k; R_0805_2012Metric; LCSC C17414
R404, R405, R406, R407, R408, R409: 22; R_0805_2012Metric; LCSC C17561
R418: 1M; R_0805_2012Metric; LCSC C17514
R419, R420, R422, R423: 49R9 1%; R_0805_2012Metric; LCSC C17720
R421: 10R 1%; R_0805_2012Metric; LCSC C17415
R424, R425, R426, R427, R429, R430: 330; R_0805_2012Metric; LCSC C17630
R428: 12k4 1%; R_0805_2012Metric; LCSC C30908
U401: W5500; LQFP-48_7x7mm_P0.5mm; LCSC C32843
Y401: 25MHz; Crystal_HC49-4H_Vertical; MPN X49SD25MSD2SC; LCSC C14730

Connections:
+3.3V: C405.1, C414.1, D401.2 (A), D402.2 (A), D403.2 (A), D404.2 (A), FB401.1, R401.1, R402.1, R403.1, R410.1, R411.1, R412.1, R429.2, R430.2, U401.28 (VDD); also elsewhere on the board
/SPI2_MISO: R406.1; also elsewhere on the board
/SPI2_MOSI: R407.1; also elsewhere on the board
/SPI2_SCK: R405.1; also elsewhere on the board
/W_CS: R404.1; also elsewhere on the board
/W_INT: R408.1; also elsewhere on the board
/W_RST: R409.1; also elsewhere on the board
/w5500/1V20: C417.1, U401.22 (1V2O)
/w5500/3V3A: C403.1, C404.1, C408.1, C409.1, C410.1, C412.1, C413.1, FB401.2, R419.1, R420.1, R421.1, U401.4 (AVDD), U401.8 (AVDD), U401.11 (AVDD), U401.15 (AVDD), U401.17 (AVDD), U401.21 (AVDD)
/w5500/ACTLED: J401.10, R426.1, U401.27 (ACTLED)
/w5500/DUPLED: R425.1, U401.26 (DUPLED)
/w5500/EXRES1: R428.1, U401.10 (EXRES1)
/w5500/LINKLED: J401.11, R427.1, U401.25 (LINKLED)
/w5500/RCT: C415.2, J401.5 (RCT), R422.2, R423.2
/w5500/RXI_N: C406.1, R422.1, U401.5 (RXN)
/w5500/RXI_P: C407.1, R423.1, U401.6 (RXP)
/w5500/RXN: C406.2, J401.6 (RD-)
/w5500/RXP: C407.2, J401.3 (RD+)
/w5500/SPDLED: R424.1, U401.24 (SPDLED)
/w5500/TCT: C411.1, J401.4 (TCT), R421.2
/w5500/TOCAP: C416.1, U401.20 (TOCAP)
/w5500/TXN: J401.2 (TD-), R420.2, U401.1 (TXN)
/w5500/TXP: J401.1 (TD+), R419.2, U401.2 (TXP)
/w5500/W_INTn: R402.2, R408.2, U401.36 (~INT)
/w5500/W_RSTn: R403.2, R409.2, U401.37 (~RST)
/w5500/W_SCSn: R401.2, R404.2, U401.32 (~SCS)
/w5500/X0: C402.2, R418.1, U401.31 (XO), Y401.1
/w5500/X1: C401.2, R418.2, U401.30 (XI/CLKIN), Y401.2
GND: C401.1, C402.1, C403.2, C404.2, C405.2, C408.2, C409.2, C410.2, C411.2, C412.2, C413.2, C414.2, C415.1, C416.2, C417.2, J401.8, J401.SH, R413.1, R414.1, R415.1, R416.1, R417.1, R428.2, U401.3 (AGND), U401.9 (AGND), U401.14 (AGND), U401.16 (AGND), U401.19 (AGND), U401.23 (RSVD), U401.29 (GND), U401.48 (AGND); also elsewhere on the board
unnamed: D401.1 (K), R424.2
unnamed: D402.1 (K), R425.2
unnamed: D403.1 (K), R426.2
unnamed: D404.1 (K), R427.2
unnamed: J401.9, R430.1
unnamed: J401.12, R429.1
unnamed: R413.2, U401.38 (RSVD)
unnamed: R414.2, U401.39 (RSVD)
unnamed: R415.2, U401.40 (RSVD)
unnamed: R416.2, U401.41 (RSVD)
unnamed: R417.2, U401.42 (RSVD)
unnamed: R406.2, U401.34 (MISO)
unnamed: R407.2, U401.35 (MOSI)
unnamed: R410.2, U401.45 (PMODE0)
unnamed: R411.2, U401.44 (PMODE1)
unnamed: R412.2, U401.43 (PMODE2)
unnamed: R405.2, U401.33 (SCLK)

Notes on the sheet:
R404–R409 22R: согласование линий SPI/управления — инженерная оценка, у WIZnet их нет. R ≈ Z0 − Rвых драйвера; на плате — у источника (МК: SCLK/MOSI/SCS/RST; W5500: MISO/INT), уточнить по осциллограмме. R401–R403 10k pull-up SCSn/INTn/RSTn со стороны W5500 — как W5500 Ethernet Shield v1.01 (R20, R2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
RSVD 38–42: DS стр.10 «NC», внутр. pull-down; 10k на GND — как Shield v1.01 (R1–R5), WIZ850io. RSVD 23: DS стр.9 «must be tied to GND» — на GND. VBG 18: DS стр.8 «must be left floating» — NC. NC 12/13/46/47, DNC 7 — скрытые выводы типа no_connect в символе W5500.
LED D401–D404: KT-0805G (C2297, InGaN), Vf 2.6–3.1 В; R424–R427 330R: I = (3.3 − Vf)/330 = 0.6–2.1 мА (без Vol). ACTLED/LINKLED: D403/D404 ≤ 2.1 + J401 ≈ 4 < 8 мА (IOL). Имена цепей MDI для дифпар KiCad (суффикс P/N): TXP/TXN, RXP/RXN; со стороны W5500 RXIP/RXIN — цепи RXI_P/RXI_N.
MDI: W5500-Ref (R1/R2/R6/R7 49R9 1%, R3 10R 1%, C9/C10 6n8, C8 22n, C15 10n), DG стр.3. 49R9 (E96): 2×49.9 = 100 Ом. TXP→TD+ (J401.1), RXP→RD+ (J401.3): как в W5500-Ref (линии у R21/R22 перекрещены) и HR911105A (P1 TD+, P3 RD+). DG стр.3 — обобщённый рисунок. Auto-MDIX нет (DS 5.5.6).
Y401 25 МГц: YXC X49SD25MSD2SC, CL 20 пФ, ESR <= 40 Ом, ±20 ppm [DS YXC]. W5500 DS 5.5.3 стр.60: C0 <= 7 пФ, ±30 ppm. CL 18 пФ в LCSC нет -> CL 20 пФ. C402/C401 = 2·(CL − Cstray) = 2·(20 − ~4) = 32 → 33 пФ (E24), C0G/NP0. WIZnet (DS рис.3, W5500-Ref C13/C14) ставит 18p: CL_eff ≈ 9 + Cstray ≈ 13 пФ.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
PMODE[2:0] = 111: all capable, auto-neg (DS стр.10). Было 10k на GND = 000 (10BT half, без auto-neg). 10k на +3.3V — как Shield v1.01 (R17–R19); внутр. pull-up 50–112k (DS стр.59).
R429/R430 330R — как W5500-Ref R8/R9. I ≈ (3.3 − Vf)/330 ≈ 4 мА (Vf ≈ 2 В — оценка, в даташ. HR911105A нет). IOL W5500 8 мА @0.4 В (DS стр.59); с D403/D404 суммарно < 6.1 мА.
FB401 + 3V3A: AVDD (выв. 4/8/11/15/17/21) и R419–R421 через бусину — W5500-Ref L1, прим. (1)g: 100–2000 Ом @100 МГц. GZ2012D601TF: 600 Ом, 0.5 А. C403–C413, C409 — на 3V3A; C405, C414 — на +3.3V (VDD). AGND = GND (DG стр.3). R428 12k4 1% (E96): задан DS стр.8 (EXRES1 12.4 кОм 1%), в E24 нет.

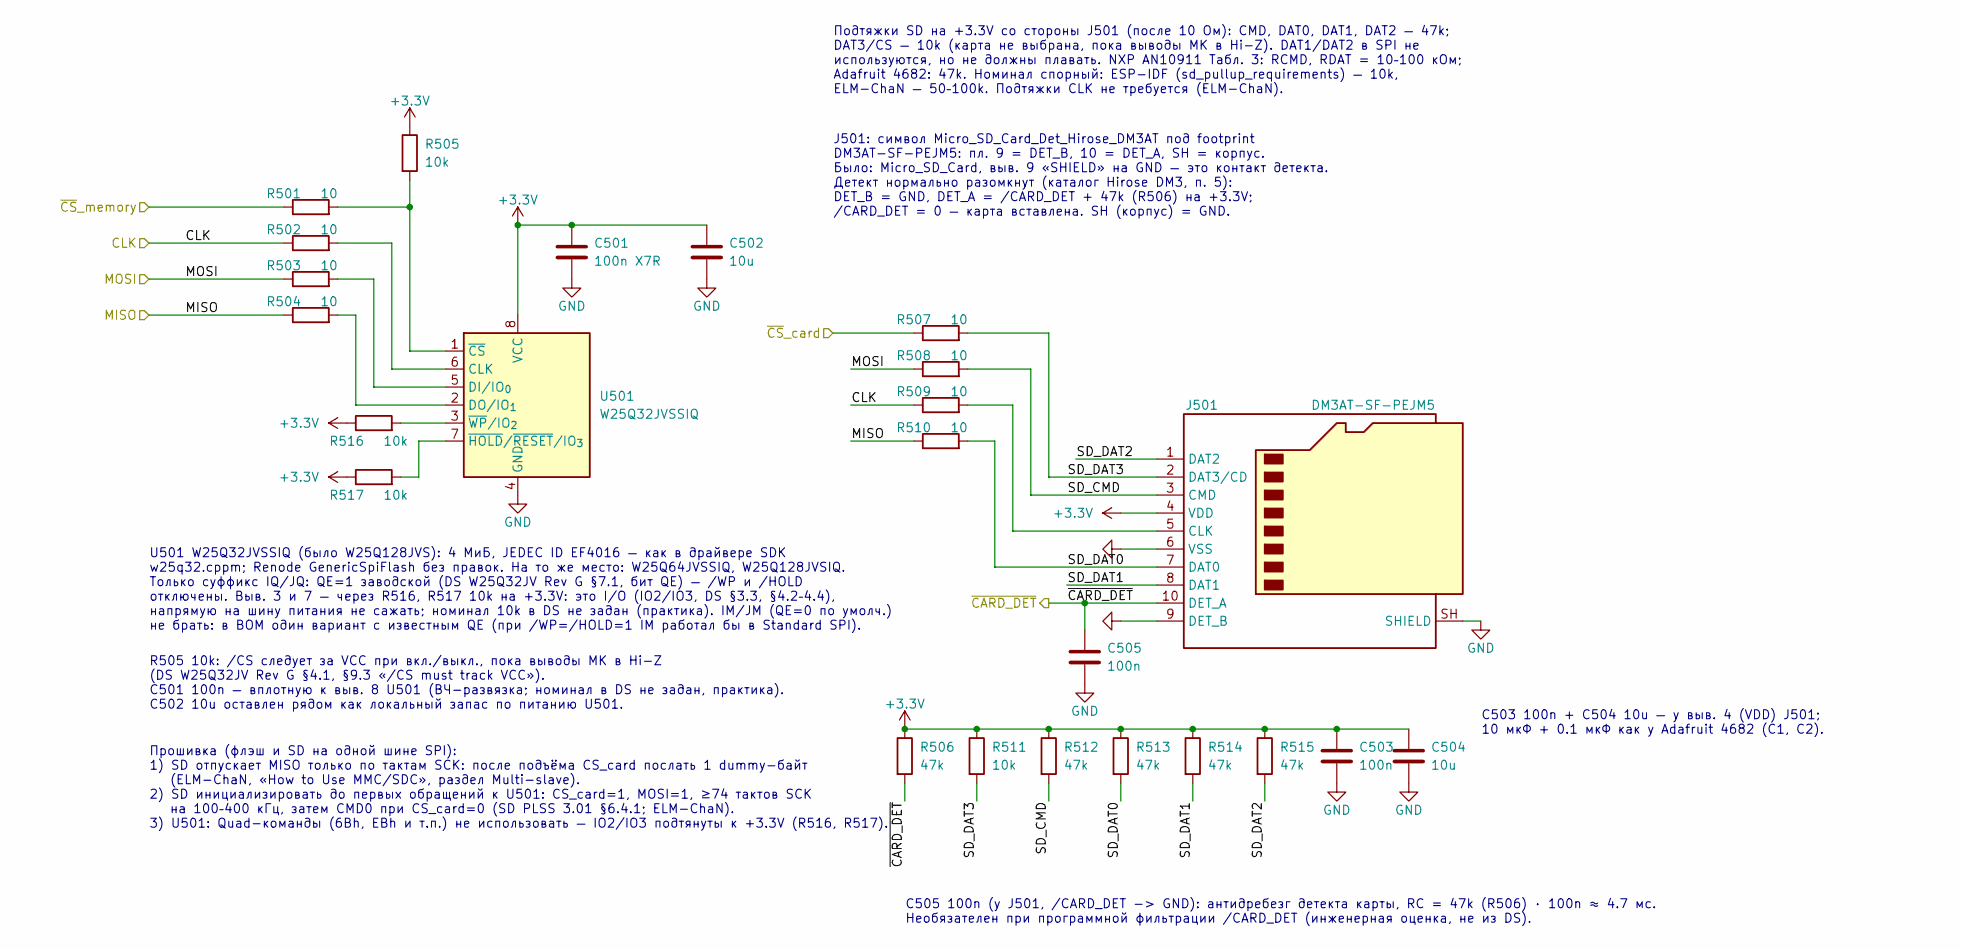
[picture p21: schematic w32.kicad_sch, W25]

Parts:
C501: 100n X7R; C_0805_2012Metric; LCSC C49678
C502, C504: 10u; C_0805_2012Metric; LCSC C15850
C503, C505: 100n; C_0805_2012Metric; LCSC C49678
J501: DM3AT-SF-PEJM5; microSD_HC_Hirose_DM3AT-SF-PEJM5; MPN DM3AT-SF-PEJM5; LCSC C114218
R501, R502, R503, R504, R507, R508, R509, R510: 10; R_0805_2012Metric; LCSC C17415
R505, R511, R516, R517: 10k; R_0805_2012Metric; LCSC C17414
R506, R512, R513, R514, R515: 47k; R_0805_2012Metric; LCSC C17713
U501: W25Q32JVSSIQ; SOIC-8_5.3x5.3mm_P1.27mm; MPN W25Q32JVSSIQ; LCSC C179173

Connections:
+3.3V: C501.1, C502.1, C503.1, C504.1, J501.4 (VDD), R505.1, R506.1, R511.1, R512.1, R513.1, R514.1, R515.1, R516.1, R517.1, U501.8 (VCC); also elsewhere on the board
/CARD_DET: C505.1, J501.10 (DET_A), R506.2; also elsewhere on the board
/FL_CS: R501.1; also elsewhere on the board
/SD_CS: R507.1; also elsewhere on the board
/SPI2_MISO: R504.1, R510.1; also elsewhere on the board
/SPI2_MOSI: R503.1, R508.1; also elsewhere on the board
/SPI2_SCK: R502.1, R509.1; also elsewhere on the board
/w32/SD_CMD: J501.3 (CMD), R508.2, R512.2
/w32/SD_DAT0: J501.7 (DAT0), R510.2, R513.2
/w32/SD_DAT1: J501.8 (DAT1), R514.2
/w32/SD_DAT2: J501.1 (DAT2), R515.2
/w32/SD_DAT3: J501.2 (DAT3/CD), R507.2, R511.2
GND: C501.2, C502.2, C503.2, C504.2, C505.2, J501.6 (VSS), J501.9 (DET_B), J501.SH (SHIELD), U501.4 (GND); also elsewhere on the board
unnamed: J501.5 (CLK), R509.2
unnamed: R502.2, U501.6 (CLK)
unnamed: R503.2, U501.5 (DI/IO_{0})
unnamed: R504.2, U501.2 (DO/IO_{1})
unnamed: R501.2, R505.2, U501.1 (~CS)
unnamed: R517.2, U501.7 (~HOLD/~RESET/IO_{3})
unnamed: R516.2, U501.3 (~WP/IO_{2})

Notes on the sheet:
Подтяжки SD на +3.3V со стороны J501 (после 10 Ом): CMD, DAT0, DAT1, DAT2 — 47k; DAT3/CS — 10k (карта не выбрана, пока выводы МК в Hi-Z). DAT1/DAT2 в SPI не используются, но не должны плавать. NXP AN10911 Табл. 3: RCMD, RDAT = 10–100 кОм; Adafruit 4682: 47k. Номинал спорный: ESP-IDF (sd_pullup_requ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
U501 W25Q32JVSSIQ (было W25Q128JVS): 4 МиБ, JEDEC ID EF4016 — как в драйвере SDK w25q32.cppm; Renode GenericSpiFlash без правок. На то же место: W25Q64JVSSIQ, W25Q128JVSIQ. Только суффикс IQ/JQ: QE=1 заводской (DS W25Q32JV Rev G §7.1, бит QE) — /WP и /HOLD отключены. Выв. 3 и 7 — через R516, R517 1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
J501: символ Micro_SD_Card_Det_Hirose_DM3AT под footprint DM3AT-SF-PEJM5: пл. 9 = DET_B, 10 = DET_A, SH = корпус. Было: Micro_SD_Card, выв. 9 «SHIELD» на GND — это контакт детекта. Детект нормально разомкнут (каталог Hirose DM3, п. 5): DET_B = GND, DET_A = /CARD_DET + 47k (R506) на +3.3V; /CARD_DET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
R505 10k: /CS следует за VCC при вкл./выкл., пока выводы МК в Hi-Z (DS W25Q32JV Rev G §4.1, §9.3 «/CS must track VCC»). C501 100n — вплотную к выв. 8 U501 (ВЧ-развязка; номинал в DS не задан, практика). C502 10u оставлен рядом как локальный запас по питанию U501.
C503 100n + C504 10u — у выв. 4 (VDD) J501; 10 мкФ + 0.1 мкФ как у Adafruit 4682 (C1, C2).
Прошивка (флэш и SD на одной шине SPI): 1) SD отпускает MISO только по тактам SCK: после подъёма CS_card послать 1 dummy-байт (ELM-ChaN, «How to Use MMC/SDC», раздел Multi-slave). 2) SD инициализировать до первых обращений к U501: CS_card=1, MOSI=1, ≥74 тактов SCK на 100–400 кГц, затем CMD0 при CS_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
C505 100n (у J501, /CARD_DET -> GND): антидребезг детекта карты, RC = 47k (R506) · 100n ≈ 4.7 мс. Необязателен при программной фильтрации /CARD_DET (инженерная оценка, не из DS).

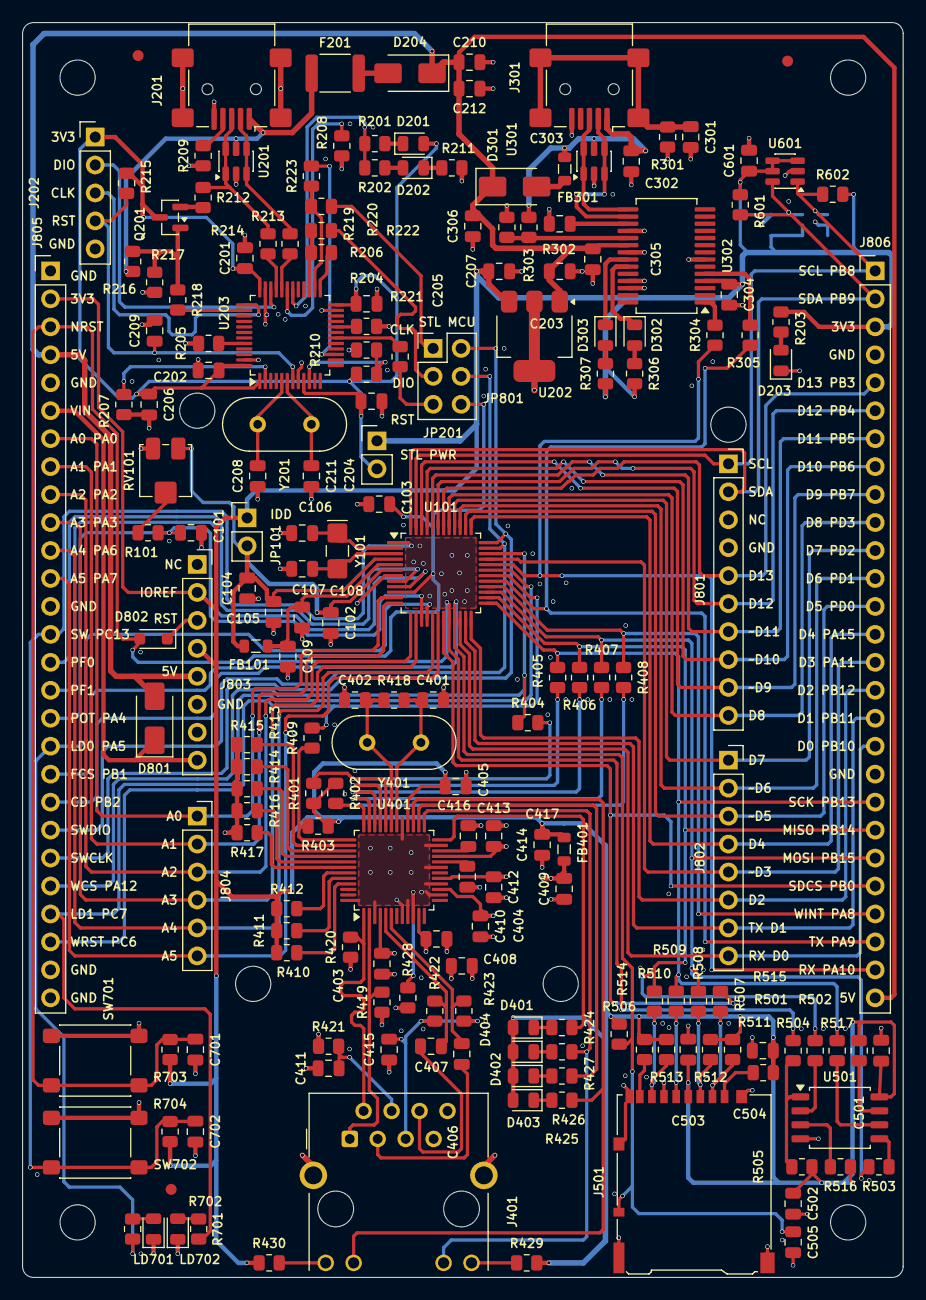
[picture p22: board g0_dev_board.kicad_pcb from above]

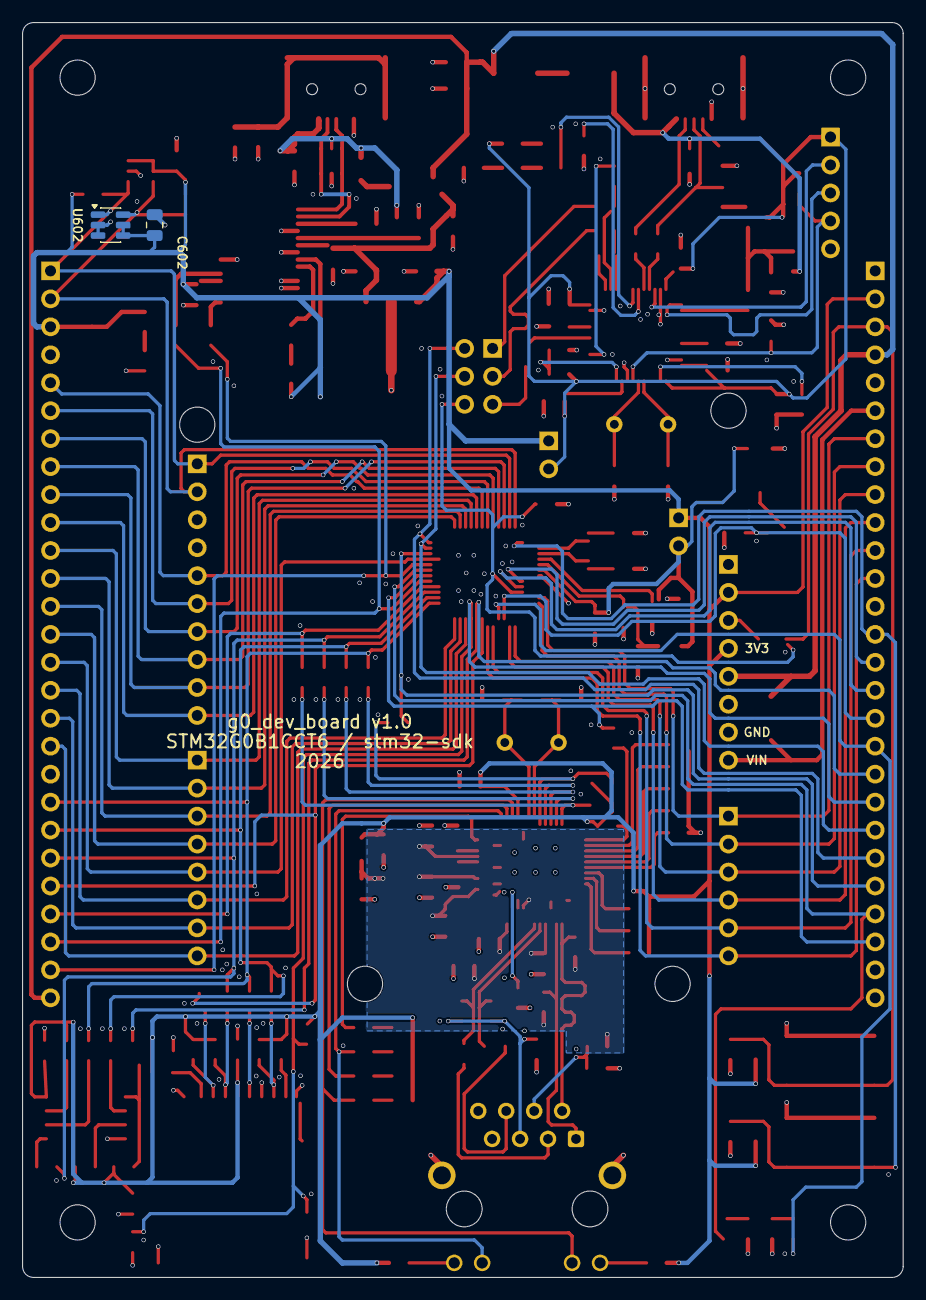
[picture p23: board g0_dev_board.kicad_pcb from below]

Board: 4 copper layers, 80.0 x 114.0 mm, 198 parts (2 on the bottom side), 151 nets.

Other parts of the board:
FID1, FID2, FID3: Fiducial_1mm_Mask2mm
H1, H2, H3, H4: MountingHole_3.2mm_M3
H801, H802, H803, H804: Arduino_MountingHole_3.2mm
