khosta77/stm32g0-dev-board/(commit log)

2026-10-18 feat: start new projects
    [cpu.kicad_sch, ft232rl.kicad_sch, g0_dev_board.kicad_pcb, g0_dev_board.kicad_sch, leds.kicad_sch, memory.kicad_sch, st_link.kicad_sch, tmp10x.kicad_sch]
2026-10-18 chore(git): extend .gitignore for KiCad artifacts
    Добавлены в игнор служебные файлы KiCad: блокировки (*.lck),
    автосохранения (_autosave-*), кэш футпринтов (fp-info-cache),
    резервные копии и производственные выходы (gerbers/, production/).
    Файл g0_dev_board.kicad_prl убран из индекса: он хранит локальное
    состояние редактора (открытые листы, видимость слоёв) и меняется
    при каждом открытии проекта.
2026-10-18 feat(schematic): fix peripheral sheets and integrate STM32G0B1CCT6
    Главный МК заменён на STM32G0B1CCT6 (LQFP-48, pin-to-pin совместим
    с STM32G071CBT6). Лист cpu переписан: обвязка по DS13560, LSE
    32.768 кГц, подстроечник на ADC (PA4), перемычка JP_IDD, таблица
    назначения выводов.
    Исправлены листы периферии:
    - st_link: перепутанные USB D+/D-, закороченные резисторы SWD,
    VBUS через PTC и Шоттки, ESD USBLC6-2SC6, LDO AP7361C-33E,
    SWO стянут на землю, J2 1x5 с NRST, перемычка JP_STL_PWR;
    - ft232rl: 3V3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
    [cpu.kicad_sch, ft232rl.kicad_sch, g0_dev_board.kicad_sch, headers.kicad_sch, memory.kicad_sch, st_link.kicad_sch, tmp10x.kicad_sch, w32.kicad_sch]
2026-10-18 refactor(schematic): re-annotate references by sheet number
    Позиционные обозначения перенумерованы по схеме «номер листа x 100»:
    cpu - 1xx, st_link - 2xx, ft232rl - 3xx, w5500 - 4xx, w32 - 5xx,
    tmp10x - 6xx, leds - 7xx, headers - 8xx. По обозначению на плате
    сразу видно, к какому листу относится компонент.
    Ссылки на компоненты в текстовых комментариях обновлены. Обозначения
    из сторонних референсных схем (MB1136, MB1184, W5500-Ref, Ethernet
    Shield, Adafruit) и имена выводов Arduino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
    [cpu.kicad_sch, ft232rl.kicad_sch, headers.kicad_sch, leds.kicad_sch, st_link.kicad_sch, tmp10x.kicad_sch, w32.kicad_sch, w5500.kicad_sch]
2026-10-18 docs: add project CLAUDE.md
    Описание проекта для работы с Claude Code: состав платы, структура
    листов и схема нумерации обозначений, правила правки схемы (KiCad
    закрыт, ERC и сравнение нетлистов), требования к плате и производству,
    нюансы для прошивки SDK, соглашение о коммитах.
2026-10-18 fix(schematic): resolve all ERC warnings
    ERC: 0 ошибок, 0 предупреждений (было 239 предупреждений).
    - w5500, leds: все объекты перенесены на сетку 1.27 мм; удалены
    два провода нулевой длины.
    - Заведена проектная библиотека g0_dev_board.kicad_sym (+ sym-lib-table)
    для намеренно изменённых символов: USB_B_Mini с пассивными
    VBUS/GND (J201, J301). Попутно исправлен номер вывода экрана
    6 -> SH: у footprint Lumberg 2486 01 площадки экрана называются SH,
    иначе эк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
    [ft232rl.kicad_sch, leds.kicad_sch, st_link.kicad_sch, w32.kicad_sch, w5500.kicad_sch]
2026-10-18 fix(schematic): harden FT232 reset and reduce NRST load
    - FT232RL: делитель RESET# R302/R303 4.7k/10k -> 1k/2.2k. Обратная
    утечка Шоттки D301 при питании платы от ST-Link поднимала RESET#
    к порогу; теперь порог достигается при 0.59 мА, что выше
    гарантированного IR max B120.
    - ST-Link: PTC F201 MF-MSMF050 -> MF-MSMF075 (R1max 1.0 -> 0.45 Ом),
    чтобы VCC FT232 оставался >= 4.0 В в худшем случае.
    - NRST: C701 и R703 на листе leds -> DNP. Остаются C103 100n у вывода
    и внутренняя подтяжка, как реком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
    [cpu.kicad_sch, ft232rl.kicad_sch, leds.kicad_sch, st_link.kicad_sch]
2026-10-18 feat(schematic): add MPN/LCSC fields and fix Q201 pinout
    Подготовка к заказу сборки на JLCPCB:
    - всем монтируемым символам добавлено скрытое поле LCSC (коды
    проверены через API JLCPCB, по возможности Basic);
    - LSE Y101: Epson FC-135 CL 7 пФ (Q13FC13500002), C106/C108 6.8p C0G,
    footprint под ручную пайку; в SDK нужен LSEDRV=10;
    - бусины: FB101/FB401 GZ2012D601TF, FB301 BLM21PG221SN1D (2 А);
    - Y401 25 МГц X49SD25MSD2SC (CL 20 пФ), C401/C402 27p -> 33p;
    - Y201 8 МГц X49SD8MSD2SC, нагрузочные 22p оставлены (предел F103
    25 пФ, с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
    [cpu.kicad_sch, ft232rl.kicad_sch, headers.kicad_sch, leds.kicad_sch, st_link.kicad_sch, tmp10x.kicad_sch, w32.kicad_sch, w5500.kicad_sch]
2026-10-18 feat(pcb): set up 4-layer stackup, rules and board mechanics
    - Стек 4 слоя 1.6 мм по JLC04161H-7628: F.Cu / In1 GND / In2 питание
    / B.Cu. Маска и tan(d) - типовые значения.
    - Правила: дорожка/зазор >= 0.15 мм, переходные минимум 0.3/0.4
    (по умолчанию 0.3/0.6), медь от края 0.3 мм.
    - Классы цепей: Power 0.5 мм, USB90 0.28/0.15, MDI100 0.24/0.18
    (оценка по IPC-2141A и Кершнингу-Янсену, уточнить калькулятором
    завода), Default 0.2 мм.
    - Схема перенесена на плату: 190 footprint, паритет схем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
    [g0_dev_board.kicad_pcb]
2026-10-18 feat(pcb): prepare board for placement
    - Зелёные LED остаются C2297 (InGaN), резисторы к ним 330 Ом (C17630):
    ток 0.6-2.1 мА при Vf 2.6-3.1 В. Жёлто-зелёные отклонены: по
    даташитам световая отдача на мА у них в ~10 раз ниже.
    - Цепи дифпар переименованы, чтобы KiCad распознавал пары:
    J201_D+/-, STL_D+/-, FT_D+/-, RXI_P/N; шаблоны классов USB90/MDI100
    обновлены.
    - Отверстия шилда H801-H804: footprint из шаблона Arduino (NPTH 3.2,
    courtyard 3.4) в проектной библиотеке g0_dev_boa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
    [ft232rl.kicad_sch, g0_dev_board.kicad_pcb, leds.kicad_sch, st_link.kicad_sch, w5500.kicad_sch]
2026-10-18 feat(pcb): draft component placement
    Черновая расстановка по эскизу E (контрольная точка перед ручной
    правкой в GUI):
    - сверху вне зоны шилда: USB J201/J301, перемычки JP801/JP101/JP201,
    J202, кнопки, светодиоды; снизу: RJ45 J401 и microSD J501 на кромке,
    светодиоды W5500;
    - под шилдом: ST-Link слева сверху, FT232 справа сверху, LDO по центру
    с медью под табом, U101 в центре (сторона SPI2/USART1/SWD к W5500),
    W5500 над RJ45, флэш и подтяжки SD на шине SPI2, TMP100 у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
    [g0_dev_board.kicad_pcb]
2026-10-18 feat(pcb): refine placement, add ground planes and route critical nets
    Расстановка доработана: кварцы Y101/Y201/Y401 вплотную к выводам, терминация MDI
    в линию между W5500 и RJ45, U203 повёрнут на 180°, флэш перенесён к microSD.
    In1.Cu и In2.Cu — сплошная GND, на внешних слоях заливка GND, ~500 переходных
    прошивки. Разведены и заблокированы: USB-пары (выровнены), MDI, кварцы, силовой
    тракт и развязка, SPI2, USART1, SWD до JP801. DRC: 0 ошибок, паритет схемы полный,
    2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
    [g0_dev_board.kicad_pcb]
2026-10-18 refactor(pcb): remove routing and ground zones for manual re-routing
    Удалены все дорожки и переходные (1555) и зоны GND на F/In1/In2/B по решению
    перейти на ручную трассировку через MCP. Доработанная расстановка из 6c14ea2
    сохранена. DRC: паритет со схемой полный, 499 неразведённых связей.
    [g0_dev_board.kicad_pcb]
2026-10-18 feat(pcb): manually route ST-Link USB, SWD and F103 escapes
    Ручная трассировка через MCP: USB-пара J201 -> USBLC6 -> 0R -> F103, SWD-цепи
    к JP801, верхний ряд выводов F103 (PA5, NRST, BOOT1), LED, SWO, SWD самого F103
    к J202. Плоскости GND на In1/In2 восстановлены. R222 и C204 повёрнуты, C202
    сдвинут на 0.4 мм ради каналов. Добавлен .kicad_dru: зазор внутри дифпар
    USB 0.15 мм и MDI 0.18 мм. DRC: 0 нарушений.
    [g0_dev_board.kicad_pcb]
2026-10-18 feat(pcb): route F103 periphery and +3V3_STL distribution
    Разведены правая и нижняя стороны F103: кварц 8 МГц, NRST к J202 и RC-цепи,
    T_VCC, PC13, BOOT0, USB_RENUM, развязка. Магистраль +3V3_STL на B.Cu:
    JP201 -> J202.1 -> D201/C202 и обход справа к C205/C201/R204/R215, ветка к
    Q201/C204. Q201 разведён. C206 перенесён в карман у J202 (у вывода 48 не было
    подхода), R205/R215 повёрнуты. GND-переходные у пассивов ST-Link. DRC: 0.
    [g0_dev_board.kicad_pcb]
2026-10-18 refactor(pcb): turn In2 into power plane with +3V3_STL island
    По решению пользователя In2 стал слоем питания: +3.3V на всю плату и остров
    +3V3_STL под ST-Link с выступом до JP201. In1 остаётся сплошной GND (опора
    для F.Cu, дифпары не затронуты). Удалены 20 сегментов магистрали +3V3_STL на
    B.Cu, которые замыкали область вокруг F103; питание выводов теперь через
    переходные в остров. C206 возвращён к выводу 48. DRC: 0 нарушений.
    [g0_dev_board.kicad_pcb]
2026-10-18 feat(pcb): rework ST-Link LED cluster and JP801 SWD lines
    R201/R202/R211 перенесены к светодиодам у верхнего края (R201/R202
    вертикально), D201/D202 сдвинуты; D203/R203 (индикатор основной +3.3V)
    перенесены к LDO, так как зона под ST-Link теперь остров +3V3_STL.
    /STL_SWDIO и /STL_SWCLK к JP801 переведены на B.Cu, связка SWCLK
    R220<->R223 сделана по F.Cu (R220 повёрнут). LED_STLINK идёт на B.Cu
    через зазор между выводами J202. DRC: 0 ошибок, 2 предупреждения о
    переходных посреди цеп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
    [g0_dev_board.kicad_pcb]
2026-10-18 feat(pcb): route ST-Link VBUS and USB ID
    VBUS_STL от J201 по B.Cu левой колонкой (x=112.9, 0.5 мм) вниз и к F201,
    отводы к U201 (переходное 0.45/0.3 между линиями D+/D-) и к R216. ID от
    J201.4 к R209 по B.Cu. GND R209 подключён к экрану разъёма по F.Cu вместо
    переходного на пути VBUS. DRC: 0 ошибок, 388 неразведённых.
    [g0_dev_board.kicad_pcb]
2026-10-18 feat(pcb): route FT232RL block
    USB-пара J301 -> USBLC6 -> FT232 (D+ по F.Cu, D- одним переходом на B.Cu
    из-за зеркального порядка выводов), VBUS_FT к ESD, FB301 и делителю RESET,
    линия FB301 -> D301 по B.Cu. Сигналы RX/TX LED выведены по F.Cu из-под
    корпуса через торец, RXD/TXD — вниз по B.Cu к R304/R305, RESET по B.Cu.
    Экран J301 связан и выведен на R301/C301. D203 сдвинута, R302/C302/C303
    повёрнуты. DRC: 0 ошибок, 342 неразведённых.
    [g0_dev_board.kicad_pcb]
2026-10-18 feat(pcb): route LDO input/output and +5V cluster
    F201 -> D204 (0.8 мм), +5V: D204/C306/C203 и D301/C210 связаны с входом
    LDO и C305/FT232 через B.Cu (прямой коридор по F.Cu перекрыт развязкой
    FT232). Выход LDO +3.3V двумя переходными в плоскость In2, таб LDO на GND
    шестью переходными. DRC: 0 ошибок, 329 неразведённых.
    [g0_dev_board.kicad_pcb]
2026-10-18 feat(pcb): route MCU top side, LSE crystal and +3V3_MCU feed
    Кварц 32 кГц, VREF+ (FB101/C107/C109), развязка C102 (повёрнут, GND
    вывода 7 напрямую), магистраль +3V3_MCU от JP101 (F.Cu -> B.Cu по
    x=134.25) с ветками к C102 и к группе FB101/C104/C105/RV101. Выводы
    BTN/PF0/PF1 выведены переходными внутрь корпуса. DRC: 0 ошибок.
    [g0_dev_board.kicad_pcb]
2026-10-18 feat(pcb): route MCU right-side fanout to Uno and logic headers
    Разведены 23 цепи правой стороны U101: D0-D13, U1_TX/U1_RX, SPI2,
    W_INT, W_CS, I2C1 к J802/J803 и гребёнке J806, диагонали J80x-J806
    и J804-J805, AREF. R801 повёрнут на 180 градусов для прохода AREF.
    DRC: новых нарушений нет, неразведённых 267.
    [g0_dev_board.kicad_pcb]
2026-10-18 refactor(pcb): reset routing, add power pins to J806, use GND on both inner layers
    Плата откатена до расстановки: удалены все дорожки, переходные и полигоны.
    Оба внутренних слоя (In1, In2) - сплошная общая GND.
    Зафиксированы только контур платы, разъёмы Uno J801-J804, гребёнки
    J805/J806 и крепёжные отверстия; остальные компоненты разблокированы
    и оставлены на своих местах для ручной трассировки.
    Схема: на гребёнке J806 вывод 3 (был AREF) ->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
    [g0_dev_board.kicad_pcb, headers.kicad_sch]
2026-10-18 chore(pcb): resave board in KiCad
    Файл пересохранён в KiCad: изменены только UUID текстовых полей
    посадочных мест, геометрия и связность платы не менялись.
    [g0_dev_board.kicad_pcb]
2026-11-07 refactor(pcb): move all non-connector parts off board for re-placement
    Все компоненты, кроме разъёмов (J201, J202, J301, J401, J501, J801-J806)
    и крепёжных отверстий, вынесены за правый край платы с группировкой по
    листам схемы. JP801/JP101/JP201 тоже вынесены - их место будет выбрано
    заново ближе к центру. Расстановка и трассировка выполняются заново
    по блокам от точек входа.
    [g0_dev_board.kicad_pcb]
2026-11-07 feat(pcb): place and route FT232RL USB-UART block
    Блок от точки входа J301: U301 (ESD) сразу под разъёмом, FT232RL
    повёрнут выводами USB к J301, обвязка с западной стороны чипа.
    - D+/D- 0.35 мм (не шире площадки FT232 0.4 мм, ~90-95 Ом на стеке
    JLC 7628). Порядок D+/D- у J301 и у FT232 зеркальный при любом
    повороте чипа, поэтому D- один раз переходит на B.Cu (2.5 мм под D+).
    - VBUS_FT 0.5 мм (ширина площадки J301): площадка VBUS справа от пары,
    потребители слева -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
    [g0_dev_board.kicad_pcb]
2026-11-07 refactor(pcb): use only 0/45/90 segments with 45-degree bends in FT232RL block
    Правило трассировки: сегменты только горизонтальные, вертикальные и
    под 45 градусов, повороты - фаской 45, без прямых углов.
    - Ручные правки в KiCad: VBUS_FT на B.Cu и цепь экрана J301 переложены
    под 45 градусов.
    - Фаски 45 на поворотах +5V, FT_RXLED, FT_TXLED, TXD, RXD.
    - FT_RESET_N - прямая линия от вывода 19 через R302 до R303 (убран
    излом 0.07 мм).
    - Выпрямлены сегменты с углами 165, 1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
    [g0_dev_board.kicad_pcb]
2026-11-07 feat(pcb): place and route ST-Link block (F103, USB, VBUS path)
    Блок программатора от точки входа J201.
    - USB: U201 (ESD) под J201, R213/R214, пара 0.3 мм (ширина площадки
    F103) до PA11/PA12. У F103 порядок D+/D- совпадает с J201 - пара идёт
    без пересечений и переходов.
    - VBUS_STL: F201 и D204 в верхней полосе между J201 и J202-старым
    местом, +5V обходит справа и сходится с +5V от FT232 у D301.
    Вывод VBUS у U201 и R216 питаются через B.Cu под парой.
    - F103 повёрнут выводами USB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
    [g0_dev_board.kicad_pcb]
2026-11-07 refactor(pcb): rework ST-Link block per review, JP801 to 2x3
    Схема:
    - JP801 заменён на 2x3 (Conn_02x03_Odd_Even, PinHeader_2x03): пара
    GND-GND 7-8 удалена вместе с символами GND, текст и Description
    обновлены. LCSC очищен: C225519 относился к 2x4, номер для 2x3
    нужно подобрать. ERC 0.
    Плата:
    - Питание -> конденсатор -> нагрузка: C302 (VBUS у J301, переходное
    на B.Cu после конденсатора), C306 (+5V от D301 через C306 к FT232),
    C210 -> C212 -> +5V, C206 у VBAT и C202 у VDD48 питаются через свои
    пло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
    [g0_dev_board.kicad_pcb, headers.kicad_sch]
2026-11-07 refactor(pcb): reroute +3V3_STL west branch with longer diagonal
    Ручная правка в KiCad: ветка +3V3_STL на B.Cu от C206 к J202 проведена
    длинной диагональю вместо двух прямых участков.
    [g0_dev_board.kicad_pcb]
2026-11-07 docs: add PCB placement and routing rules (RULES.md)
    Свод практик, выработанных при трассировке блоков FT232 и ST-Link:
    порядок работы, геометрия и ширина дорожек, переходные и слои,
    топология питания (питание -> конденсатор -> нагрузка), выравнивание
    длин пар, правила расстановки и проверки блока перед коммитом.
    CLAUDE.md ссылается на RULES.md.
2026-11-07 feat(pcb): place and route Ethernet W5500 analog part (stage E1)
    W5500 над RJ45 J401, кварц Y401, линии MDI, аналоговое питание и
    развязка. SPI/INT/RST, подтяжки RSVD/PMODE и светодиоды - этап E2.
    - MDI 0.3 мм с зазором 0.24 мм (~100 Ом на стеке JLC 7628).
    Порядок выводов RJ45 (TXP, TXN, RXP, TCT, RCT, RXN) зеркален
    относительно W5500 для обеих пар при любом повороте чипа, поэтому
    TXP и RXP одним переходом уходят на B.Cu и садятся прямо на
    THT-выводы разъёма; TCT и RCT заход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
    [g0_dev_board.kicad_pcb]
2026-11-07 refactor(pcb): move RJ45 J401, reroute +5V branch (manual edit)
    Ручная правка в KiCad: J401 перенесён в (129.72, 137.42), отвод +5V от C212
    перерисован с более длинной диагональю, удалена надпись зоны шилда на Dwgs.User.
    Трассировка MDI под новое положение J401 будет переделана отдельно.
    [g0_dev_board.kicad_pcb]
2026-11-07 docs: revise routing rules against vendor guides (RULES.md)
    Правила сверены с WIZnet Hardware Design Guide, ST AN2867, TI/Microchip по развязке
    и статьями по целостности сигнала. Изменения:
    - §1.6: требования производителя чипа важнее общих правил;
    - §2.1: 45° оставлено ради технологичности, без ссылки на целостность сигнала;
    - §3.1/3.4/3.5: приоритет импеданса для пар, ширина питания по току, MDI 0.3/0.24;
    - §4.4: в MDI и OSC переходных нет; §4.7: GND-переход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
2026-11-07 fix(pcb): add GND return vias next to signal vias (RULES.md §4.7)
    По §4.7 у каждого сигнального переходного F.Cu-B.Cu должно быть GND-переходное
    в пределах 1 мм: опорный слой меняется In1 -> In2, обратному току нужен мост.
    Добавлено 13 GND-переходных в блоках ST-Link и FT232: T_VCC, F103_NRST, STL_SWO_IN (2),
    STL_PA5 (2), LED_STLINK (2), F103_SWDIO, F103_SWCLK, PC13, FT_D- (2).
    Точки подобраны скриптом с проверкой зазоров, DRC в блоках без новых нарушений.
    Переходные блока W5500 уб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
    [g0_dev_board.kicad_pcb]
2026-11-07 feat(pcb): rework Ethernet W5500 block for the new RJ45 position
    Блок W5500 разведён заново под J401 в (129.72, 137.42) по обновлённому RULES.md.
    U401 r90 в (133.75, 113.0): сторона MDI смотрит на J401, SPI и кварц вверх, к будущему МК.
    MDI без переходных (§4.4, WIZnet):
    - TX подходит сверху: TXN прямо в вывод 2, TXP огибает вывод 2 через зазор 2/4
    и проход между рядами в вывод 1. Разница компенсирована змейкой TXN слева: 22.00/22.00 мм;
    - RX подходит снизу по правой стор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
    [g0_dev_board.kicad_pcb]
2026-11-07 fix(pcb): address Ethernet block review findings
    По итогам независимого ревью блока W5500:
    - вывод 11 (3V3A) соединён дорожкой с площадкой C404 (§5.1), переходное под корпусом убрано;
    - пара RX у правого края J401 сдвинута на 0.15 мм: зазор RXN до вывода 8 (GND) 0.38 мм вместо 0.23;
    C406 перенастроен, длины RX 31.90/31.73 мм (разница 0.17);
    - граница выреза GND под J401 опущена до y 140.0: RXP идёт в 0.7 мм от края вместо 0.41;
    - последний сегмент TXN заканчива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
    [g0_dev_board.kicad_pcb]
2026-11-07 docs(pcb): add board dimensions on User.1, align MDI100 net class
    На User.1 нанесены размеры как на чертеже: габарит 80 x 114 мм, привязка крепёжных
    отверстий H1-H4 (5 мм от краёв, межосевые 70 и 104 мм), примечания: 4 отв. Ø3.2,
    скругление R1, толщина 1.6 мм, 4 слоя.
    Класс цепей MDI100 приведён к фактической разводке и RULES.md §3.5: 0.3/0.24 (было 0.24/0.18).
    [g0_dev_board.kicad_pcb]
2026-11-07 feat(pcb): place LDO and route +3.3V distribution (power block)
    LDO U202 (AP7361C-33E, SOT-223) в (146.5, 64.5) под шилдом (высота ~1.8 мм), выводами вверх:
    +5V -> C203 -> IN, OUT -> C207 -> переходное в магистраль (§5.1).
    Теплоотвод: вывод 2 (GND, «язычок») на медь F.Cu 7 x 9 мм с 28 переходными в обе GND.
    Оценка нагрузки +3.3V по даташитам: W5500 до 132 мА (DS v1.0.2 §5.4) плюс F103, FT232 VCCIO,
    флэш, SD, МК, светодиоды и вывод 3.3V шилда — порядка 0.35-0.5 А; рассеиваемая мощность
    (Vin - 3.3) x I д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
    [g0_dev_board.kicad_pcb]
2026-11-07 fix(pcb): replace 90-degree T-junctions with 45-degree branches
    Прежняя проверка углов смотрела только изломы из двух сегментов и пропускала Т-отводы.
    Новая проверка учитывает отводы от середины сегмента и в центрах площадок.
    Найдено и исправлено 37 отводов под 90° (магистрали +3.3V/+5V/+3V3_STL, отводы
    к терминаторам MDI, X0/X1, GND конденсаторов, ST-Link, FT232): ветвь теперь отходит
    отрезком 45°. Точки подобраны с проверкой зазор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
    [g0_dev_board.kicad_pcb]
2026-11-07 feat(pcb): place MCU G0B1 with LSE, decoupling and VREF (stage M1a)
    U101 (STM32G0B1CCT6, LQFP-48) r0 в (138.0, 86.0), в центре между ST-Link и W5500.
    Поворот выбран перебором: левая сторона (OSC32, питание, PF0/PF1, NRST, A0/A1) смотрит
    к J803-J805, верх и правая сторона (D-линии, I2C, SPI, USART, SWD) — к J801/J802/J806 и FT232.
    - LSE Y101 вертикально у выводов 2/3: дорожки OSC32_IN/OUT симметричны (~3.9 мм), без
    переходных и чужих дорожек под кварцем; C106/C108 слева, GND переходными (AN2867, §6.4, §6.6).
    -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
    [g0_dev_board.kicad_pcb]
2026-11-07 feat(schematic): reassign MCU pins to match board routing
    Назначение выводов U101 переставлено под геометрию платы (МК r0, разъёмы J801/J802/J806 справа,
    J804/J805 слева, W5500 снизу). Функции сверены по DS13560 Rev 6 табл. 12 (FT/TT, ADC) и табл. 13-20 (AF):
    - верх корпуса подряд к J801/J806: PB9 SDA, PB8 SCL, PB7 D13, PB6 D12, PB5 D11 (TIM3_CH2), PB4 D10
    (TIM3_CH1), PB3 D9 (TIM1_CH2), PD3 D8, PD2 D7, PD1 D6 (TIM17_CH1), PD0 D5 (TIM16_CH1), PA15 D4;
    - справа PA11 D3 (TIM1_CH4), PA8 W_INT, PA12 SD_CS; SWD, USART1, LED0/1, SPI2 - без изменений;
    - низ: PA2/PA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
    [cpu.kicad_sch, g0_dev_board.kicad_pcb]
2026-11-07 refactor(pcb): lengthen 45-degree branch segments on power nets
    Y-отводы на цепях питания (+3.3V, +5V, +3V3_STL, 3V3A, GND, VBUS) удлинены с 0.6 до 1.2-2.0 мм
    там, где позволяют зазоры: 25 отводов. DRC и проверка зазоров без новых нарушений.
    [g0_dev_board.kicad_pcb]
2026-11-07 fix(pcb): align LSE load caps, add GND return vias under MCU (§4.7)
    C106/C108 выровнены точно по площадкам Y101 (наклон 0.005 мм давал сегменты не под 0°).
    У переходных захваченных выводов МК (BTN, PF0, PF1, NRST, A0) добавлены GND-переходные ≤ 1 мм.
    [g0_dev_board.kicad_pcb]
2026-11-07 refactor(pcb): reroute +3.3V trunk to free B.Cu east of the MCU
    Вертикаль магистрали +3.3V по B.Cu на x 152.95 между y 70 и 110.75 удалена: она
    перегораживала нижний слой между МК и FT232, J801/J802, J806, microSD.
    - W5500 (C405 -> VDD28, C414 -> FB401 -> 3V3A) теперь питается от западной ветви
    по B.Cu на y 98.6 (между низом МК и кварцем Y401; под корпусом кварца не проходит,
    от него отделён двумя внутренними GND), далее вниз к C414 и в нижнюю часть магистрали
    (светоди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
    [g0_dev_board.kicad_pcb]
2026-11-07 feat(pcb): route SWD, NRST and USART1 from MCU (stage M1b)
    SWD и NRST к JP801, USART1 к FT232 через последовательные R304/R305.
    - SWCLK/SWDIO (выв. 36/35): короткая лесенка 45° вверх-вправо к переходным у угла корпуса,
    далее по B.Cu на север коридором между западной ветвью +3.3V (x 141.25) и переходными
    теплоотвода LDO; порядок NRST/SWDIO/SWCLK = x 141.9/142.45/143.0 совпадает с порядком
    выводов JP801 6/4/2; у JP801 подъём на F.Cu (B.Cu к THT мешает ветвь +3.3V).
    - NRST: от переходно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
    [g0_dev_board.kicad_pcb]
2026-11-07 fix(pcb): clean up junction remnants after branch lengthening
    Перепроверка нашла последствия автоматической правки отводов:
    - скрипт удлинения отводов принял 45-градусные фаски обычных поворотов за Y-отводы
    и передвинул их; соединение сохранилось, но от прежних поворотов остались висящие
    огрызки на +3.3V (6), +5V (1), +3V3_MCU (2) - удалены;
    - VDD28 W5500 после правки садился на стаб переходного между C405 и переходным, а не на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
    [g0_dev_board.kicad_pcb]
2026-11-07 refactor(pcb): move west +3.3V branch to F.Cu to open B.Cu around the MCU
    Западная ветвь +3.3V (x 117.6) на B.Cu вместе с горизонталью y 98.6 замыкала
    область МК: к J803/J804/J805 нужно провести 18 линий (A0-A5 и сигналы гребёнки ЛА),
    а через зазоры между выводами J803 проходило не больше пяти.
    - вертикаль x 117.6 от JP101.1 до y 122.6 перенесена на F.Cu (канал между J803/J804
    и R413-R417), отводы к J803.2/J803.4 и к R410-R412 — Y-отводами на F.Cu;
    - JP101.1 теперь питается с B.Cu се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
    [g0_dev_board.kicad_pcb]
2026-11-07 refactor(pcb): feed W5500 +3.3V south of Y401 to free B.Cu under the crystal
    Питание W5500 (узел VDD 138.4, 104.1 и восточная ветвь) теперь идёт от переходного
    у R412 (124.49, 114.9) по B.Cu: вверх по x 124.49 и по y 104.4 южнее кварца Y401.
    Горизонталь y 99.9 у верхнего края Y401 удалена.
    Полоса B.Cu под корпусом Y401 (y 99.4-103.9) освобождается под линии от МК на запад.
    Решение согласовано: дорожки на B.Cu под HC49 допускаются не ближе 0.5 мм
    к его площадкам, от кварц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
    [g0_dev_board.kicad_pcb]
2026-11-07 docs(rules): allow B.Cu traces under a THT crystal over solid GND (§6.6)
2026-11-07 refactor(pcb): clear B.Cu south of the MCU for the west-bound bundle
    - питание W5500: фид по B.Cu перенесён с y 104.4 на y 108.2 (северный край острова 3V3A),
    переход VDD (138.4, 104.1) спущен к фиду по x 138.4; цепочка через (141, 100.6)-(143, 98.6)-
    (147.2, 100.6) удалена, узел FB401 (147.2, 108.75) подключён к фиду напрямую;
    - переходное питания C102 перенесено с (129.25, 89.6) на (126.75, 89.6) - освобождает сечение
    x ~129 для линий от МК на запад;
    - A0 больше не уходит под корпус (пе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
    [g0_dev_board.kicad_pcb]
2026-11-07 fix(pcb): remove acute corner at C102 supply pad
    [g0_dev_board.kicad_pcb]
2026-11-07 feat(pcb): route A0-A5 from the MCU to J804
    A0/A1 (выводы 11/12) наружу, A2/A3/A4/A5 (13/14/17/18) веером вниз; по F.Cu полосами
    y 93.05-95.55 под нижней стороной МК, спуском x 125.3-127.8 в зону между МК и J803,
    переходы в два ряда (y 99.0/100.5, шаг 0.6), дальше по B.Cu коридором x 120.4-123.4
    к площадкам J804.1-6 с востока. Переход на B.Cu неизбежен: западнее МК на F.Cu
    развязка и ветвь +3.3V (x 117.6).
    GND-мосты (§4.7) для этих переходов будут поставлены после разводки л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
    [g0_dev_board.kicad_pcb]
2026-11-07 fix(pcb): shift A0-A5 vias east to leave room for LA turn-downs
    [g0_dev_board.kicad_pcb]
2026-11-07 feat(pcb): route BTN/PF0/PF1/POT/NRST/W_RST west from under the MCU
    POT и W_RST (выводы 15/16) выведены переходами под корпус - иначе пересекают A4/A5.
    Из-под корпуса шесть линий идут по B.Cu на запад под левым рядом выводов, затем:
    BTN/PF0/PF1/POT - вверх через проход между J803.1 и JP101 к северной части полосы у J805;
    W_RST и NRST - к щелям J803 (y 91.58 и 94.12). +3V3_MCU от JP101.2 идёт тем же проходом
    к будущему RV101. Старые GND-мосты BTN/PF0/PF1 под корпусом сняты, пос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
    [g0_dev_board.kicad_pcb]
2026-11-07 feat(pcb): route FL_CS/CARD_DET/SD_CS/LED0/LED1/SWD LA lines west of the MCU
    FL_CS и CARD_DET - переходами под корпус (наружу по F.Cu потом пойдут на восток),
    SD_CS/LED1/LED0 - переходами на концах веера, ответвления SWDIO/SWCLK - от их переходов
    на восток и вниз. Все семь линий по B.Cu идут на запад под нижним краем МК, между
    переходами GND C401/C402 и C109 перестраиваются и в зоне у J803 спускаются к щелям J803
    (y 96.66-105.71). GND-переход R413 снят: подтяжки R413-R417 с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
    [g0_dev_board.kicad_pcb]
2026-11-07 feat(pcb): add GND return vias next to new signal vias around the MCU (§4.7)
    Мосты поставлены у переходов SD_CS, SWCLK, BTN, POT/W_RST, FL_CS, CARD_DET, PF0, PF1, A5.
    Без моста (нет места в радиусе 1 мм): A0-A4 (аналоговые входы, медленные), SWDIO и LED0 -
    ближайший GND 1.3-4 мм; отмечаю как отступление от §4.7 для медленных линий.
    [g0_dev_board.kicad_pcb]
2026-11-07 refactor(schematic): reorder LA header J805.14-25 to match the routing order
    Сигналы на J805.14-25 переставлены в порядок, в котором трассы выходят из-под МК
    к гребёнке без пересечений: BTN, PF0, PF1, POT, W_RST, FL_CS, CARD_DET, SWDIO, SWCLK,
    SD_CS, LED1, LED0 (было FL_CS, SD_CS, CARD_DET, W_RST, LED0, LED1, BTN, POT, PF0, PF1,
    SWCLK, SWDIO). Набор сигналов прежний, J805.1-13 и 26-27 не тронуты. Текст на листе headers
    обновлён. Цепи площадок J805 на плате обновлены, ERC 0, расхождений плата-схема 0.
    Перес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
    [g0_dev_board.kicad_pcb, headers.kicad_sch]
2026-11-07 feat(pcb): route the left LA header J805 and the Uno-to-LA bundle
    - жгут Uno->ЛА по F.Cu: J804.1-6 (A0-A5) -> J805.7-12, J803.2 (+3.3V) -> J805.2,
    J803.5 (+5V) -> J805.4, J803.8 (VIN) -> J805.6, NRST через D802 -> J805.3;
    - D802 (BAT54WS) у J803.3 (SH_RESET), D801 (B120) между +5V и VIN у J803.5-.8;
    - линии ЛА по B.Cu: BTN/PF0/PF1/POT с севера через проход у J803.1, остальные через
    щели J803 и промежуток J803/J804 к J805.14-25;
    - RV101/R101/C101 у верхнего конца полосы, +3V3_MCU от JP101.2 по B.Cu, POT переходом
    на R101/C101;
    - GND R207 (ST-Link) переведён на п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
    [g0_dev_board.kicad_pcb]
2026-11-07 feat(pcb): feed +5V to J805.4/J803.5 along the top and west board edges
    +5V снят переходом у катода D204 (137.2, 38.6) и по B.Cu (0.5 мм) проведён вдоль верхнего
    края платы над J201 (y 37.0) и по западной кромке за гребёнкой J805 (x 100.95) к J805.4;
    дальше по F.Cu жгута - к J803.5 (5V Uno) и D801. B.Cu вдоль краёв свободен: у J201 все
    площадки SMD на F.Cu. Осталось +5V к J806.27 (правая гребёнка).
    [g0_dev_board.kicad_pcb]
2026-11-07 feat(pcb): place RESET/USER buttons and status LEDs in the bottom-left corner
    SW701 (RESET) и SW702 (USER) с C701/C702 и подтяжками R703/R704, LD701/LD702 с R701/R702
    в левом нижнем углу - вне зоны шилда, доступны и видны. NRST подведён от J805.3 по F.Cu
    вдоль западной кромки, BTN от J805.14 по B.Cu там же, LED0 по B.Cu и LED1 по F.Cu - спуском
    вдоль J805. Подтяжки питаются от ветви +3.3V (B.Cu x 117.6) Y-отводами.
    [g0_dev_board.kicad_pcb]
2026-11-07 feat(pcb): GND return vias for NRST/BTN/POT/LED0 vias on the left side (§4.7)
    [g0_dev_board.kicad_pcb]
2026-11-07 feat(schematic,pcb): swap W_RST and LED0 MCU pins, reroute LED0 to the corner
    W_RST перенесён на PC6 (вывод 30), LED0 на PA5 (вывод 16, TT - для бортового
    светодиода допустимо; ШИМ сохраняется через TIM2_CH1 AF2, DS13560 табл. 13,
    DS12232 табл. 13). На J805 сигналы .18/.25 поменялись местами (LED0/W_RST).
    Таблица выводов и тексты листа cpu обновлены. ERC 0.
    Плата: уже проложенные дорожки переименованы. LED0 от J805.18 идёт по B.Cu
    вдоль западной кромки x 101.2 и под J805.27 выхо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
    [cpu.kicad_sch, g0_dev_board.kicad_pcb, headers.kicad_sch]
2026-11-07 feat(pcb): route the D4-D13/I2C harness from the MCU top side to J801/J802
    Верхние выводы U101 (SDA, SCL, D13..D4) идут по F.Cu вложенными Г с шагом 0.5 на восток
    (полосы y 75.0-80.5) и вертикалями x 162.0..157.0 к площадкам J801/J802 с запада.
    SDA обходит J801.1 сверху (y 74.8, до отверстия H801 0.52 мм) и входит в J801.2 с востока.
    Полоса x 155-156.5 оставлена под D3..D0 к J802.5-8.
    [g0_dev_board.kicad_pcb]
2026-11-07 feat(pcb): W5500 west side: SPI escape vias, pull-ups and W_RST/RSTn
    Выводы 32-36 W5500 выходят вложенными Г по F.Cu к колонке переходов x 130.0 (шаг 0.6).
    R401/R402 вертикально под зоной Y401, R403 (RSTn вверх) на вертикали RSTn, R409 у полосы W_RST
    с переходом (127.6,99.8). Отвод VDD W5500 перенесён на B.Cu под кварцем (y 103.3) к фидеру
    по x 126.49, переход C405 GND - на (140.3,104.1): освобождают проход SPI по B.Cu.
    RULES §6.6: исключение 2 - SPI W5500 по B.Cu пересекает X0/X1 у выводов 30/31.
    [g0_dev_board.kicad_pcb]
2026-11-07 feat(pcb): route MCU SPI2 to the W5500 series resistors R404-R408
    SCK/MISO/MOSI/W_INT лесенкой диагоналей под TX (шаг 0.72 по x-y) к ряду R405-R408 (y 95.5),
    переходы ряда - начала шины SPI2 по B.Cu. Сторона W5500: переходы под резисторами, B.Cu-полосы
    y 105.3-107.1 к колонке x 130.0. R404 под полосой W_CS, SCSn по B.Cu y 104.7.
    GND-переход у TX перенесён на (147.6,90.0).
    [g0_dev_board.kicad_pcb]
2026-11-07 feat(pcb): route MCU bottom-right pins (W_CS, FL_CS, CD, D0-D3) eastwards
    Нижние выводы 19-24 спускаются с лесенкой отводов (шаг 0.25 по высоте) к полосам y 101.0-103.5
    и вертикалям x 153.4-156.0; D0-D2 входят в J802.6-8 с запада, D3 - полосой y 85.0 и вертикалью
    x 156.5 в J802.5. W_CS: отвод на R404, переход (153.4,108.0), B.Cu до (158.9,114.44), F.Cu
    через промежуток J802.5/6 в J806.23. FL_CS/CD продолжатся к флэшу и SD.
    [g0_dev_board.kicad_pcb]
2026-11-07 feat(pcb): SPI2/W_INT/U1 bus to J806.20-26 through the J802 pin gaps
    Шина по B.Cu: полосы y 86.25-93.3 от переходов ряда R405-R408 и от TX/RX, вертикали x 159.6-162.6,
    переходы на уровнях J806.20-26, далее F.Cu прямо через промежутки J802 в площадки J806.
    RX выходит на F.Cu (147.0->149.0,86.25) восточнее вертикали TX. GND-переход у TX - (148.2,88.6).
    [g0_dev_board.kicad_pcb]
2026-11-07 feat(schematic,pcb): swap W_CS and SD_CS MCU pins, move R404 next to W_CS
    SD_CS перенесён на PB0 (вывод 19), W_CS - на PA12 (вывод 34): обе ноги GPIO без AF.
    SD_CS идёт нижней полосой к microSD и на J806.23, W_CS - прежним путём на J805.23.
    На гребёнках ЛА подписи J805.23/J806.23 поменялись, тексты листов cpu/headers обновлены. ERC 0.
    R404 стоит над D-полосами (145.9,99.6): вход от перехода (145.6,95.3) на вертикали W_CS,
    выход SCSn переходом (147.9,99.6) на B.Cu-полосу y 104.7.
    [cpu.kicad_sch, g0_dev_board.kicad_pcb, headers.kicad_sch]
2026-11-07 fix(pcb): manual cleanup of VBUS_FT and W5500 ACTLED/DUPLED tracks
    Правки вручную в KiCad: убраны лишние изломы VBUS_FT у FT232 и узлы ACTLED/DUPLED у R424/R426.
    [g0_dev_board.kicad_pcb]
2026-11-07 fix(pcb): drop the LDO_GND copper zone and thermal via array at U202
    AP7361C-33E (SOT-223) не требует теплового полигона: зона LDO_GND и 27 GND-переходов под ней убраны.
    Оставлен один GND-переход (146.5,69.4) у теплоотвода - единственная связь вывода GND стабилизатора
    с внутренними слоями, и переход-мост (143.75,65.6) у SWCLK (§4.7).
    [g0_dev_board.kicad_pcb]
2026-11-07 feat(pcb): Uno-to-LA B.Cu bundle J801/J802 -> J806.1-18, TX/RX and J806.3 feed rework
    16 линий (SCL, SDA, D13..D0) по B.Cu вложенными Г, вертикали x 166.2-176.1 (шаг 0.66),
    верхние линии западнее. Вертикаль SCL отстоит от отверстия H801 на 0.32 мм.
    TX/RX к R304/R305: вертикали x 162.0/161.4, переходы (162.0,67.4)/(161.4,68.4) с GND-мостами.
    +3.3V на J806.3: B.Cu над жгутом (y 56.9) и вдоль восточной кромки (x 179.0), R203 от J806.3 по F.Cu.
    GND D203 - по F.Cu на J806.4 вместо перехода в зоне жгута.
    [g0_dev_board.kicad_pcb]
2026-11-07 feat(pcb): place and route the W25Q32 flash and microSD block
    Шина SPI2 идёт цепочкой МК -> SD -> флэш: отводы на последовательные R510/R509/R508 у J501,
    затем B.Cu-полосы (MOSI 122.7, SCK 123.3, MISO 124.5 от R510, FL_CS 125.7) к U501 восточнее J501.
    У J501: подтяжки R514/R513/R512/R511 и C503 прямо над контактами, последовательные резисторы
    рядом выше, их стороны карты - по B.Cu к переходам у контактов. R515/C504 восточнее, R506 на CD.
    U501 (0 град.): CS/DO слева, CLK/DI справа, обвязка св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
    [g0_dev_board.kicad_pcb]
2026-11-07 feat(pcb): place and route TMP100 sensors U601/U602 east of J801
    U601/U602 друг под другом между J801 и J806. SCL - переходом с B.Cu-вертикали жгута (166.2,71.51)
    через R602, SDA - ответвлением от обхода J801 петлёй снизу (y 80.6) к шине x 175.21 и R601.
    +3.3V внутрь кольца SDA/SCL - B.Cu-полосками между линиями жгута (y 72.53, 77.66, 82.69) от
    восточной кромки (x 179.0), продолжение фидера J806.3. GND-переходы - между рядами жгута.
    D203 получил свой GND-переход вместо линии к J806.4;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
    [g0_dev_board.kicad_pcb]
2026-11-07 docs(schematic): fix stale A4/A5 port names in the headers sheet note
    A4/A5 подключены к PA6/PA7 (таблица выводов листа cpu), а не к PB0/PB1.
    [headers.kicad_sch]
2026-11-07 feat(pcb): feed +5V to J806.27 along the top and east board edges
    F.Cu 0.4 мм от C210 (+5V у D204): вдоль верхней кромки (y 37.3) и восточной (x 179.2) в J806.27 с востока.
    B.Cu у восточной кромки занята фидером +3.3V, поэтому F.Cu.
    [g0_dev_board.kicad_pcb]
2026-11-07 feat(pcb): GND return vias next to new signal vias (§4.7)
    37 GND-переходов в пределах 1 мм от сигнальных переходов SPI, SD, флэша, W5500, I2C, CS и шины J806.
    Для 18 переходов в плотных пучках (шина у J806, ряд A0-A4, SWDIO, W_RST, часть колонки x 130.0)
    места в радиусе 1 мм нет - оставлены как есть, ближайший GND 1.1-5.6 мм (In1/In2 обе GND).
    [g0_dev_board.kicad_pcb]
2026-11-07 docs(rules): §4.7 exception for GND return vias in dense via bundles
    18 сигнальных переходов в плотных пучках без места под мост в 1 мм; оценка влияния ~0.5 Ом на 100 МГц.
2026-11-07 feat(schematic,pcb): Uno R3 SPI on D11-D13, drop R802/R803
    Совместимость с шилдами Uno R3: D13 = PB3 (SPI1_SCK), D12 = PB4 (SPI1_MISO), D11 = PB5 (SPI1_MOSI, ШИМ TIM3_CH2),
    D10 = PB6 (ШИМ TIM1_CH3, SS), D9 = PB7 (ШИМ TIM17_CH1N); одинаково у G0B1 и G071
    (DS13560 табл. 15, DS12232 табл. 14). Таблица выводов и тексты листа cpu обновлены.
    R802/R803 удалены: A4/A5 (PA6/PA7) на G0B1 сами работают как I2C2_SDA/SCL (AF8, DS13560 табл. 14);
    у G071 этой возможности нет (DS12232 табл. 13) - записано на листе headers. ERC 0.
    Плата: жгут D4-D13 п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
    [cpu.kicad_sch, g0_dev_board.kicad_pcb, headers.kicad_sch]
2026-11-07 feat(schematic,pcb): drop R801, leave Uno AREF (J801.3) unconnected
    Внешняя опора АЦП с шилда не нужна: R801 удалён, J801.3 помечен no-connect, иерархическая цепь
    VREF+ между листами cpu и headers убрана (VREF+ теперь локальная цепь листа cpu). Тексты обновлены.
    ERC 0; DRC: медь без нарушений, расхождений со схемой 0, несоединённых цепей 0.
    [cpu.kicad_sch, g0_dev_board.kicad_pcb, g0_dev_board.kicad_sch, headers.kicad_sch]
2026-11-07 feat(pcb): move TMP100 pair above J806, U602 to the bottom side
    U601 (F.Cu) и U602 (B.Cu) с обвязкой перенесены в свободную зону над J806
    (x 164-176, y 46-56), чтобы освободить полосы под подписи выводов гребёнок
    J801/J806. Один датчик на нижней стороне — по требованию: сравнение
    температуры сторон платы. U602 и C602 — единственные компоненты на B.Cu.
    I2C отводится от J806.1/J806.2 двумя параллельными диагоналями по F.Cu,
    к U602 — переходные SCL (172.0, 53.1)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
    [g0_dev_board.kicad_pcb]
2026-11-07 docs(schematic): refresh board summary text, keep RV101 on +3V3_MCU
    Текст «Состав платы» на корневом листе приведён к нетлисту: CS/INT/RST W5500
    (PA12/PA8/PC6), CS флэш PB1, CS SD PB0 и детект PB2, D0/D1 = LPUART1,
    D2-D10 по факту, LED0 PA5, обозначения JP101/JP801/JP201 и J805/J806.
    В таблице выводов листа cpu исправлены устаревшие FB200/C200/C201.
    RV101 оставлен на +3V3_MCU: PA4 типа TT_a, положительная инжекция запрещена
    (DS13560 табл. 22). Цена — 0.33 мА в токе JP_IDD, обоснование на схеме.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
    [cpu.kicad_sch, g0_dev_board.kicad_sch]
2026-11-07 feat(pcb): silkscreen labels, fiducials, LED row spacing
    Шелкография:
    - подписи всех выводов J805/J806 (сигнал + порт МК), J801-J804 по Uno R3,
    J202 (SWD F103), JP801 (STL/MCU, CLK/DIO/RST), JP101 IDD, JP201 STL PWR;
    три подписи J803 (3V3, GND, VIN) не помещаются сверху — на B.SilkS;
    - позиционные обозначения 0.8 мм / линия 0.15 мм, расставлены вне площадок
    и чужих контуров; все видимы;
    - название, МК и год на нижней стороне.
    Реперные знаки FID1-FID3 (1 мм, маска 2 мм) в свободн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
    [g0_dev_board.kicad_pcb]
2026-11-07 chore(pcb): clear User.Drawings layer
    Удалён единственный объект слоя — прямоугольник контура шилда Uno
    (113.3-166.7 x 57.3-125.9). DRC: 0 замечаний.
    [g0_dev_board.kicad_pcb]
2026-11-07 fix(rules): add mm units to diff pair clearance constraints
    KiCad 10 требует явных единиц в .kicad_dru: без них правила USB90/MDI100
    не разбирались и не действовали. Значения те же: 0.15 мм и 0.18 мм.
    DRC: 0 замечаний.
2026-11-07 chore(pcb): manual tweaks — U202 reference position, drop GND via at (158.95, 107.19)
    Ручные правки пользователя в KiCad. DRC: 0 замечаний, 0 несоединённых.
    [g0_dev_board.kicad_pcb]
2026-11-07 fix(pcb): drop orphan GND via at (165.60, 70.91)
    Мост §4.7 бывшего перехода SCL у прежнего места TMP100 — после переноса
    датчиков ближайший сигнальный переход в 4.9 мм. Проверка переходных:
    все 347 -> 346 размером 0.4/0.3, подключённых менее чем на двух слоях нет,
    остальные 86 GND-переходов без дорожек — мосты §4.7 (<= 1 мм от сигнального)
    и сшивка GND-зон под U101/U401. DRC: 0 замечаний.
    [g0_dev_board.kicad_pcb]
2026-11-07 chore(pcb): remove standoff note from H801
    Удалена пометка на Cmts.User у отверстия шилда H801
    ("M3 standoff: nylon / low-profile head (3.5 mm to J801)").
    На Gerber не влияла. DRC: 0 замечаний.
    [g0_dev_board.kicad_pcb]
2026-11-07 docs: add CERN-OHL-P v2 licensing, project docs and JLCPCB manufacturing outputs
    Структура по образцу PSU-EXT hardware, проект KiCad остаётся в корне.
    - LICENSE: официальный текст CERN-OHL-P v2 (OHWR), NOTICE с уведомлением
    об авторском праве и адресом источника, AUTHORS.md, CHANGES.txt (запись
    v1.0.0, требование п. 3.3(b)), CONTRIBUTING.md, README.md.
    - THIRD-PARTY-NOTICES.md: библиотеки KiCad (CC BY-SA 4.0 с исключением для
    проектов), изменённый USB_B_Mini и отверстие из шаблона Arduino_Uno.
    - manufacturing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
    [BOM-g0_dev_board.csv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]
2026-11-07 docs(readme): use board.png as the main board image
    Вместо двух рендеров (верх/низ) в README — 3D-вид платы docs/images/board.png.
    Рендеры pcb-top.png/pcb-bottom.png остаются в docs/images и генерируются скриптом.
2026-11-07 chore(docs): drop PCB renders and the render step from export script
    Удалены docs/images/pcb-top.png и pcb-bottom.png (в README используется
    board.png). scripts/export_manufacturing.py больше не рендерит 3D и не
    принимает --no-render; выгрузка занимает ~14 с вместо ~73 с.
    README, CONTRIBUTING.md и CLAUDE.md приведены в соответствие.
